jloganolson/logans-first-robot-pcb/red-team-findings/2026-11-10/README.md

# Review material, 10 November 2026

| File | What it is |
|---|---|
| `FINDINGS.md` | The first independent cost and design review that led to v0.10. Partly superseded; see its banner. |
| `evidence/` | Scripts and results behind that review (copper resistance, USB impedance, board occupancy). |
| `argon/` | Two reviews by Google Gemini (Argon), with the prompts used. Reproduced as received; they contain errors. |
| `reviewer-3-feedback.md` | A third AI review that put the order on hold over inductor voltage ratings. |
| `thermal/` | A simple board-heating model and its results. |

How each finding was checked and what was done about it is in
[`docs/HANDOFF_V10_VALUE_ENGINEERED.md`](/docs/HANDOFF_V10_VALUE_ENGINEERED.md).
The prompt files are raw instructions to an AI model and read that way.
