jloganolson/logans-first-robot-pcb/red-team-findings/2026-11-10/reviewer-3-feedback.md

# Third independent review of the Y5 package (10 November 2026)

Pasted by the owner from a separate reviewing agent. Reproduced as received,
with local file links removed. Its datasheet citations were not attached.

> I'd hold payment on Y5. The saved quote is $294.18 before shipping for five
> boards with two assembled. I verified that the board, Gerbers, BOM and
> placement file match the quoted package, including all 304 fitted positions.
> The order files check out.
>
> The reason to hold is six inductors on the battery-fed regulators. Y5 still
> specifies the Sunlord parts at L2-L6 and L7002. Sunlord lists 30 V for both
> exact part numbers. When a regulator starts with its output discharged, the
> voltage across its inductor can approach the full 33.6 V pack voltage during
> a switching pulse. I'd order once Sunlord confirms that waveform is
> acceptable or those six positions use suitably rated parts. The previously
> priced 75 V Vishay option would put Y5 around $307.46 with one additional
> feeder, subject to a fresh quote and footprint check. (Sunlord voltage
> table, p. 21; Vishay ratings.)
>
> The new Thor inductor is an improvement. I independently get about 26.1 A
> peak under overload using the handoff's assumptions. The manufacturer lists
> 29 A as typical at 25 C, at roughly 30% inductance loss. Normal 8 A
> operation has substantially more margin. I'd verify overload behavior with a
> dummy load before connecting Thor. (Cjiang datasheet.)
>
> Before factory release, I'd also ask JLCPCB to confirm the nine large
> electrolytic capacitors stay within Lelon's 250 C case-temperature limit on
> its fixed 255 +/-5 C Economic reflow process. The oven setting alone can't
> establish the capacitor temperature. (Lelon reflow profile; JLCPCB process.)

## Follow-up check

The same Cjiang datasheet (FEXL series, general notes, item 8) states
"absolute maximum voltage: DC 30V". The new Thor inductor L1 therefore has the
same 30 V limit the reviewer raised for the Sunlord parts. See the HOLD section
of `docs/HANDOFF_V10_VALUE_ENGINEERED.md`.
