jloganolson/logans-first-robot-pcb/red-team-findings/2026-11-10/argon/argon-review-of-v11-1c351a03d3f0.md

### Overall Verdict: **DO NOT ORDER (`HOLD` on `Robot_PDB_v11_Gerbers_Y6`)**

While the compact 228 × 155 mm floorplan, the `L1` reversion to the 60 V Coilcraft `XAL1510-103MED`, and the `audit_v11.py` invariant checks outside the servo block are well-conceived, **direct inspection of the v0.11 geometry, layer plots, and JLCPCB placement preview (`outputs/v11-order-preparation/factory-placement-preview-servo-block.png`) reveals multiple critical assembly and layout defects**, plus the unresolved v0.10 component-rating blockers:

1. **BLOCKER (Assembly / CPL Rotations — Visible in `factory-placement-preview-servo-block.png`):**
   - **All `SOT-23` / `SOT-23-5` / `SOT-23-6` parts (`Q7001`, `U7006`, `U7009`, `U1`, `U11`, `U17`, `U9900`, `U9904`) are rotated 90° off their pads** in `CPL_JLCPCB.csv` due to the `(r'^SOT-23', -90)` rule in `export_v11.py`. In `factory-placement-preview-servo-block.png`, the black package bodies and leads of `Q7001` `(110.1, -127.0)`, `U7006` `(151.0, -120.0)`, `U7009` `(153.0, -136.0)`, and `U1` `(23.0, -64.0)` sit vertically (pins North/South) while their copper pads sit horizontally (West/East).
   - **All six `SS1060` buck catch diodes (`D7101` in the servo block, plus `D101, D201, D301, D401, D501` on the main board) are 180° reversed** in `CPL_JLCPCB.csv` (no `^D_SMC` offset in `export_v11.py`). In `factory-placement-preview-servo-block.png`, `D7101` at `(28.5, -135.8)` shows its purple cathode `+` band at the bottom (`y = 139.2`, Pad 2 = `GND`), directly opposite the white silkscreen cathode bar at the top (`y = 132.4`, Pad 1 = `IO_PWM_SW`). `D301` and `D401` show the exact same 180° inversion. Assembling `SS1060` reversed places the Schottky diode forward-biased from `SW` to `GND`, shorting every `TPS54560` high-side FET to ground on the first switching cycle.
2. **BLOCKER (Unresolved from v0.10 Hold):** Six `Sunlord MWSA1004S` buck inductors (`L2–L6, L7002`) remain rated at 30 V DC max against a 33.6 V (8S Li-ion) battery bus, and the nine `10×10 mm` Lelon electrolytic capacitors remain unverified against JLCPCB Economic PCBA’s 255 ± 5 °C peak reflow profile.
3. **HIGH-RISK LAYOUT DEFECTS in the Re-Laid Servo Block (`build_v11.py`):**
   - **Broken high-frequency input capacitor return loop on `U7003` (`C7101–C7103`):** Rotating block `A` placed `C7101–C7103` `GND` pads at `(32.92, 141.8..145.0)` with their 27 `GND` vias at `x = 25.9..31.5`, while `U7003`'s `PWM_VIN` F.Cu zone and vias sit at `x = 34.7..38.7`. **Zero `GND` vias exist in the `U7003` `GND` zone (`x = 24.5..34.1`) closer than 7.5 mm to `U7003` pin 7 (`38.06, 133.1`)**, and the `F.Cu` ground path between `C7101–C7103` `GND` and `U7003` EP (`38.7, 135.8`) is completely severed by `C7104` and the `IO_PWM_SW` pour.
   - **Unnecessary 1,242 mm² overlap between `PWM_VIN` (`B.Cu`, 33.6 V) and `PWM_5V` (`In2.Cu`, 5 V):** `PWM_5V` on `In2.Cu` was drawn from `x = 6.0` to `126.47`, blanketing the entire `PWM_VIN` input section (`x = 35.1..84.6`). Consequently, `F7000` Pad 2 (`PWM_VIN` PTH at `57.25, 125.85`) and all 13 `PWM_VIN` vias punch directly through the `PWM_5V` plane separated by only a `0.30 mm` antipad clearance, and `PWM_VIN` on `B.Cu` capacitively couples across the `0.21 mm` prepreg to `PWM_5V` on `In2.Cu`.
   - **Single 0.30 mm via bottleneck on `C7111` (`100 µF` input bulk capacitor) `GND` and `D7001` (`SMCJ36CA` 5 A TVS) pads:** `C7111` Pad 1 (`PWM_VIN`) has four vias, but `C7111` Pad 2 (`GND`, `66.5, 136.8`) has only **one** `0.30 mm` via (`67.3, 136.8`) and is isolated from the `F.Cu` `GND` pour (`ISLAND_REMOVAL_MODE_ALWAYS` removed the trapped `F.Cu` pour inside `C7111`'s courtyard, visible in `v11-servo-block-F_Cu-and-silk.png`). Worse, `D7001` (`SMCJ36CA` clamping transient surges) connects to `PWM_VIN` (`B.Cu`) and `GND` (`In1.Cu`) through **only a single `0.30 mm` via on each pad** (`76.75, 139.9` and `76.75, 133.1`) at the end of a `0.22 mm` wide `F.Cu` trace!

---

### Detailed Answers to the 9 Review Questions

#### 1. Servo 5 V Buck (`U7003` TPS54560DDAR) and Input Path (`F7000`, `C7111`, `D7001`)
* **Current path from `VIN` (`In2.Cu`) → `F7000` → `PWM_VIN` (`B.Cu`) → `C7111`/`D7001` → `U7003`:**
  * **`VIN` finger on `In2.Cu`:** Runs `x = 93.25..100.25, y = 108.0..128.85` (width `7.0 mm` on 0.5 oz `17.5 µm` copper; cross-section `0.1225 mm²`, `R ≈ 3.1 mΩ` over 20 mm). At 5 A continuous (or ~1.1 A input at 24 V → 5 V / 5 A), a 7 mm wide 0.5 oz finger easily carries the current (< 2 °C rise).
  * **CRITICAL — `D7001` (`SMCJ36CA`) and `C7111` (`100 µF`) via/trace bottlenecks:**
    * In `v11-servo-block-geometry.txt` (lines 67–75, 372–373, 1507–1508, 1703–1704, 1773–1777):
      * `D7001` Pad 1 (`PWM_VIN` at `75.95, 139.9`) is on `F.Cu`, where there is **no `PWM_VIN` zone**. Its entire connection to the `B.Cu` `PWM_VIN` plane is a single **`0.22 mm` wide, `0.8 mm` long `F.Cu` track** (`75.95,139.9 -> 76.75,139.9`) into a **single `0.6/0.3 mm` via** (`76.75, 139.9`)!
      * `D7001` Pad 2 (`GND` at `75.95, 133.1`) is enclosed inside `D7001`'s silkscreen/courtyard box (`v11-servo-block-F_Cu-and-silk.png`), which isolated it from the `F.Cu` `GND` pour; it connects to `GND` solely through a **`0.22 mm` wide `F.Cu` stub** into a **single `0.6/0.3 mm` via** (`76.75, 133.1`)! A `SMCJ36CA` TVS is rated for ~25 A peak pulse current; a `0.22 mm` trace and a single `0.3 mm` via will fuse open during a clamping event.
      * Similarly, `C7111` Pad 2 (`GND` at `66.5, 136.8`) is isolated on `F.Cu` (the `GND` pour inside `C7111`'s outline was removed as an island) and connects to `In1.Cu`/`B.Cu` `GND` via **one `0.22 mm` stub (`66.5,136.8 -> 67.3,136.8`) and one `0.6/0.3 mm` via** (`67.3, 136.8`).
  * **High-frequency input loop (`C7101/C7102/C7103` to `U7003` pin 2 `VIN` and pin 7/EP `GND`):**
    * `U7003` pin 2 (`PWM_VIN`) is at `(38.06, 138.5)` and `C7101–C7103` Pad 1 (`PWM_VIN`) are at `x = 34.87..35.87, y = 139.2..145.0`, joined directly by the `F.Cu` `PWM_VIN` zone (`34.7, 137.7 .. 38.7, 147.8`). That half of the loop is tight.
    * **However, the `GND` return half is wide:** `C7101–C7103` Pad 2 (`GND`) are at `x = 32.92..33.32, y = 139.2..145.0` in the `F.Cu` `GND` zone (`24.5, 137.4 .. 34.1, 147.8`). Between that zone (`x ≤ 34.1`) and `U7003`'s thermal pad (`38.7, 135.8`), `C7104` (`35.1, 136.8`) and the `IO_PWM_SW` pour (`22.1, 122.7 .. 40.05, 136.1`) block any direct `F.Cu` connection. Thus, the high-frequency switching input current (`di/dt`) must go down the `GND` vias at `x = 31.5, y = 141.4..147.0` onto `In1.Cu` and back up `U7003`'s thermal vias at `x = 36.9..40.5, y = 135.2..136.4`—a ~8–10 mm loop on `In1.Cu`. Adding 2–3 `GND` vias at `(33.5, 139.0)` directly beside `C7103` Pad 2 would tighten this loop.
  * **`PWM_VIN` island on `B.Cu` (`x = 35.1..84.6, y = 120.0..148.2`):**
    * **Overlap with `IO_PWM_SW` (`F.Cu`) and `L7002`:** `IO_PWM_SW` on `F.Cu` spans `x = 22.1..40.05, y = 122.7..136.1`, and `L7002` Pad 1 (`IO_PWM_SW`) is at `(37.95, 124.8)` (pad extends to `x = 40.0`). Thus, `PWM_VIN` on `B.Cu` (`x ≥ 35.1, y ≥ 120.0`) overlaps `L7002`'s switch-node pad and the `IO_PWM_SW` zone over `x = 35.1..40.05, y = 122.7..136.1` (~67 mm²). Because solid `In1.Cu` (`GND`) and `In2.Cu` (`PWM_5V`) sit between `F.Cu` and `B.Cu`, direct capacitive coupling from `F.Cu` (`SW`) to `B.Cu` (`PWM_VIN`) is shielded.
    * **Real issue with `PWM_VIN` (`B.Cu`) and `PWM_5V` (`In2.Cu`):** `PWM_VIN` (`B.Cu`, `x = 35.1..84.6, y = 120.0..148.2`) lies directly beneath `PWM_5V` (`In2.Cu`, `x = 6.0..126.47, y = 112.6..154.4`), separated only by the `0.21 mm` `7628` prepreg! There is no reason for `PWM_5V` on `In2.Cu` to extend into `x = 32..60, y = 120..146` where `U7003` (`VIN`/`COMP`/`RT`/`EN`), `C7111`, `D7001`, and `F7000` Pad 2 live. Currently, `U7003`'s `COMP`/`FB`/`RT` ground vias (`45.1, 128.6..141.4`), `U7003`'s 8 `PWM_VIN` vias, `C7111`'s 4 `PWM_VIN` vias, and `F7000` Pad 2 (`PWM_VIN`) all punch through `PWM_5V` (`In2.Cu`) with `0.30 mm` clearance, and `PWM_5V` sits directly under `U7003`'s sensitive analog `FB`/`COMP` network (`x = 39..51, y = 127..133`).
  * **Output path (`L7002` → `C7105–C7108`, `C7112` → `PWM_5V` `In2.Cu` → `J7004–J7006` and `U7007`):**
    * `L7002` Pad 2 (`28.45, 124.8`), `C7105–C7108` Pad 1 (`25.15, 120.6..127.8`), and `C7112` Pad 1 (`13.7, 124.8`) sit in the `F.Cu` `PWM_5V` zone (`13.7, 114.3 .. 31.2, 129.8`, filled `140 mm²`).
    * It drops to `In2.Cu` (`PWM_5V`) through **9 vias of `0.6/0.3 mm`** near `L7002`/`C7105–C7108` (`26.7, 121.8..127.8`, `28.7, 121.8..127.8`, `29.7, 119.8`) plus 1 via at `C7112` (`13.7, 124.0`). At ~0.8–1.0 A per `0.3 mm` via, 9 vias comfortably handle 5 A continuous, and `J7004–J7006` Pin 2 (`PWM_5V`) are PTH pads directly connected (`ZONE_CONNECTION_FULL`) to `In2.Cu` (`PWM_5V`).
    * **Feedback sense (`IO_PWM_FB_TOP` / `R7108` / `R7101`):** `R7101` Pad 1 (`PWM_5V` at `43.92, 130.2`) connects via `(45.1, 130.2)` directly to the `In2.Cu` `PWM_5V` plane (and also has the legacy `0.3 mm` `B.Cu` track to `29.7, 119.8`), so feedback sensing is Kelvin-tapped off the output capacitor region and plane.

#### 2. Eleven Rebuilt Signal Routes and Two Dangling Vias
* **Signal integrity & return paths:**
  * `IO_PWM1_OUT` (`56.08 mm`, 0 vias, `F.Cu`), `IO_PWM2_OUT` (`45.08 mm`, 0 vias, `F.Cu`), and `IO_PWM3_OUT` (`34.08 mm`, 1 via at `123.48, 140.75`, `B.Cu`) are `0.25 mm` wide tracks driven through `100 Ω` series source-termination resistors (`R7054–R7056`) at ~50–500 Hz hobby-servo PWM rates. Over solid `In1.Cu` `GND` (`F.Cu`) and `In2.Cu` `PWM_5V` + `B.Cu` `GND` pour (`B.Cu`), return paths are continuous and well-damped by `R7054–R7056`.
  * **Staircase ("Manhattan/45° sawtooth") routing artifact on `IO_PWM1_OUT`, `IO_PWM2_OUT`, `IO_PWM3_OUT`, `IO_SERVO_ARM`, `IO_V3_PWM`, `IO_PWM_SWCLK`, `IO_PWM_SWDIO`:** Because `Router.path()` in `build_v11.py` searches an 8-connected `0.1 mm` grid without post-smoothing colinear staircases, shallow diagonals are emitted as dozens of `0.1 mm` horizontal + `0.14 mm` diagonal micro-jogs (e.g., lines 479–547 of `v11-servo-block-geometry.txt` have **68 track segments** just to traverse 8 mm from `x = 74.08, y = 147.15` to `66.68, 150.6`). Electrically and for Gerber photoplotting (`0.20–0.25 mm` aperture) this is benign, though unsightly.
  * **Redundant `IO_V3_PWM` `0.20 mm` `F.Cu` track (`45.98 mm`):** `build_v11.py` routed a `0.20 mm` `F.Cu` trace from `TP7002` (`156.0, 150.0`) along the bottom edge (`y = 153.1`) to `J7008` Pin 1 (`112.17, 151.0`). Because `J7008` Pin 1 is only the SWD target-voltage sense (`VREF`, < 1 mA; `hand-fit-and-harness.csv` explicitly warns *"do not inject debugger power"*), a `0.20 mm` trace is electrically adequate, though extending the `In2.Cu` `IO_V3_PWM` zone left from `x = 127.07` to `111.0` would have connected `J7008` Pin 1 directly on the plane without slicing the bottom `F.Cu` ground pour.
  * **`SWD` lines (`IO_PWM_SWDIO` `28.5 mm`, `IO_PWM_SWCLK` `24.82 mm`, `IO_PWM_NRST` `18.34 mm`):** Short (< 30 mm), continuous `GND` reference on `In1.Cu` and `F.Cu`/`B.Cu` pours; completely fine for 4–8 MHz SWD debugging.
  * **Two dangling vias (`IO_PWM2_OUT` at `118.86, 138.0775` and `IO_PWM3_OUT` at `122.81, 138.2275`):** Confirmed harmless `0.25 mm` stub vias next to `R7055`/`R7056` Pad 2 (`119.08, 138.15` and `123.08, 138.15`). Easily pruned in `build_v11.py` by removing stub tracks ending at a via with no second-layer connection.

#### 3. Servo Controller (`U7002` STM32F072CBT6) and USB Tail (`P4_DP`, `P4_DM`, `V5_USB`)
* **`P4_DP` / `P4_DM` length and symmetry:** Shortened from `172.84 / 173.41 mm` in v0.10 to `109.84 / 110.41 mm` in v0.11 (`Δ = 0.57 mm`, well within USB 2.0 Full-Speed 12 Mbps skew budgets of several centimetres).
* **Geometry and reference plane (`v11-servo-block-geometry.txt` lines 1443–1493):**
  * From the hub side (`y = 100..109`), `P4_DP`/`P4_DM` run on `B.Cu` (`0.17 mm` width, `0.46 mm` centre-to-centre pitch → `0.29 mm` gap) over the dedicated `In2.Cu` `GND` shield island (`zone GND In2.Cu prio 100 bbox 168.54,97.83..172.46,110.17`), transition through the pair vias at `(170.15, 109.0)` and `(170.85, 109.0)` flanked by twin ground return vias at `(169.2, 109.0)` and `(171.8, 109.0)`, and then run exclusively on `F.Cu` (`170.27, 110.0` → `163.27, 116.4..133.4` → `U7009` ESD array → `U7002` pins 32/33) over the **unbroken `In1.Cu` `GND` plane**. This is a clean Full-Speed USB layout improvement over v0.10.
* **Decoupling, crystal (`Y7002`), and `U7006` (`3.3 V` LDO):** Rigidly translated by `(+51.0, -12.0) mm`; all local decoupling (`C7021–C7028`), crystal loading (`Y7002`, `C7029`, `C7030`), and `IO_V3_PWM` `In2.Cu` plane connections (`x = 127.07..167.18, y = 112.6..154.4`) are intact.

#### 4. Thermal Impact on `U7003` (Servo 5 V Buck)
* `U7003` (`TPS54560DDAR`) steps ~24–29.6 V down to 5.0 V at up to 5 A peak (typically 0.5–1.5 A average for three `MG90S` micro-servos; even 3× stalled `MG90S` at ~0.75 A each is ~2.25 A).
* At 1.5 A average (`7.5 W` out), `U7003` + `D7101` + `L7002` dissipate ~`1.1 W` total; at 3 A continuous (`15 W` out), ~`2.4 W`.
* `U7003`'s exposed thermal pad (`38.7, 135.8`) has 8× `0.30 mm` thermal vias stitching directly into the full-board `In1.Cu` `GND` plane (`33,765 mm²`) and the new `F.Cu` (`8,284 mm²`) and `B.Cu` (`8,167 mm²`) lower-strip ground pours. Moreover, moving `U7003` into the bottom-left corner keeps it ≥ 50 mm away from the main board's hot spots (`U7` AUX 12 V buck at `151.5, 40.0` and `U2` Thor buck at `60.0, 34.0`). Thermal performance of `U7003` in v0.11 is **better than v0.10** and is not a thermal risk.

#### 5. Mechanical Changes, Edge Clearances, and Silkscreen Collisions
* **Board outline & mounting holes:** Outline is `228.0 × 155.0 mm`. Three M3 NPTH holes moved (`H7002` to `105.17, 151.3`, `H7003` to `3.5, 151.5`, `H7004` to `176.0, 151.5`); `H7001` (`3.0, 116.0`, wall `1.4 mm` to left edge) and the 11 main-board holes are unchanged. **Owner/mechanical CAD sign-off is required** for the 40 mm shorter lower edge, the 3 moved holes, and the new positions of `J7004–J7006`, `J7008`, `J9928`, and `F7000`.
* **Bottom-edge connector & silkscreen clearances (`H = 155.0 mm`):**
  * `J7004–J7006` pads are at `y = 150.6` (`3.55 mm` pad-edge to board edge); `J7008` pads are at `y = 151.0` (`3.15 mm` to board edge).
  * **Silkscreen clipping on `J7008 PWM SWD`:** In `build_v11.py` line 225, `texts['J7008 PWM SWD']` was placed at `y = 151.0 + 3.0 = 154.0 mm` (1.0 mm from the bottom edge). In `v11-servo-block-F_Cu-and-silk.png`, the text `J7008 PWM SWD` sits directly across the bottom silkscreen courtyard line of `J7008` and within ~0.5 mm of the bottom `Edge.Cuts` line.
  * **Silkscreen misplacement on `F7000 PWM 5A`:** `F7000` spans `x = 55.0..99.5, y = 121.6..130.1`, with its two PTH pads at `(57.25, 125.85)` and `(97.25, 125.85)`. Because `build_v11.py` line 226 computed `q = xy(fps['F7000'].GetPosition())` (`97.25, 125.85`) and set the text to `(q[0] - 20.0, q[1] - 5.2) = (77.25, 120.65)`, that works, **Wait:** in `v11-servo-block-F_Cu-and-silk.png`, look at the two mounting holes `H9910` (`58.0, 115.0`) and `H9911` (`86.0, 115.0`) and `F7000`'s pads at `(57.25, 125.85)` and `(97.25, 125.85)`: `F7000` has **no courtyard or body outline on `F.SilkS`**, so only two bare rings appear 40 mm apart with `F7000 PWM 5A` floating between them. Worse, `C7111` (`62.5, 136.8`, `10×10 mm` cap, top edge `y = 131.4`) and `D7001` (`75.95, 136.5`, top edge `y = 131.6`) sit only **1.3–1.5 mm below the 45 mm long body of the Schurter `8020.5075.PT` cartridge fuse (`y = 121.6..130.1`)**—tight for hand soldering a large cartridge fuse next to a `10×10 mm` electrolytic cap.

#### 6. Audit Script (`audit_v11.py`) Blind Spots
`audit_v11.py` accurately verifies that the 291 non-servo footprints, pads, tracks, and zones above `y = 110.5` match v0.10 and that schematic-to-board netlists match. However, it has **five significant blind spots**:
1. **Does not audit `CPL_JLCPCB.csv` rotations against package pin-1 / cathode geometry:** `export_v11.py` only asserts that unmoved parts kept their v0.10 CPL rotation and moved parts changed by `turn`. Because v0.10's CPL rotations were never audited part-by-part, `export_v11.py` faithfully propagated the 90°-rotated `SOT-23`s and 180°-reversed `D_SMC` diodes into v0.11.
2. **Does not check via count or trace width on high-current / surge pads inside the servo block:** It cannot catch that `D7001` (`SMCJ36CA`) and `C7111` (`GND`) are necked down to a single `0.22 mm` trace and a single `0.30 mm` via.
3. **Does not check cross-layer plane overlap hazards:** It does not flag that `PWM_VIN` (33.6 V) on `B.Cu` and `PWM_5V` (5 V) on `In2.Cu` overlap across `1,242 mm²` or that `F7000` Pad 2 (`PWM_VIN`) punches through `PWM_5V` with `0.30 mm` clearance.
4. **Does not check `F.Cu` zone island removal around SMD pads:** It did not catch that `ISLAND_REMOVAL_MODE_ALWAYS` deleted the `F.Cu` `GND` pour around `C7111` Pad 2 and `D7001` Pad 2 because their own silkscreen/courtyard/pad geometries pinched off the `0.25 mm` minimum pour width.
5. **Allows dangling vias/tracks if total DRC warning count ≤ v0.10 (`sum(kinds.values()) <= sum(base.values())`):** Because one `track_dangling` warning disappeared in v0.11 (`10 → 9`), `audit_v11.py` allowed a new `via_dangling` warning (`1 → 2`) to pass silently.

#### 7. Open Items from the v0.10 Hold (`L1`, `L2–L6`/`L7002`, Electrolytic Reflow)
* **`L1` (`Coilcraft XAL1510-103MED`, LCSC `C3911782`, 60 V):** **Resolved.** `BOM_JLCPCB.csv` line 12 specifies `10uH 22A 60V,L1,L_Coilcraft_XAL1510-103,C3911782`, matching the schematic and board.
* **`L2–L6, L7002` (`Sunlord MWSA1004S`, LCSC `C408487` / `C408485`, 30 V rated):** **NOT resolved — still a BLOCKER for 8S (33.6 V max) operation.** During buck high-side FET on-time into a discharged output (startup or output short), the full input voltage (`V_IN - V_OUT`, up to `33.6 V` at startup) appears across the inductor terminals, exceeding the 30 V DC rating of the `MWSA1004S` family (`L2, L3, L4, L5, L6, L7002`). (Note: `L70–L73` are on the 12 V audio speaker outputs and are well within 30 V.)
* **Nine `10×10 mm` Lelon electrolytic capacitors (`C3, C4, C14, C7111` `C249468`; `C20` `C3029711`; `C311, C411, C7112, C88` `C249933`) in Economic reflow:** **NOT resolved.** Standard 10×10 mm SMD aluminum electrolytics are rated for 235–250 °C peak reflow depending on voltage class, whereas JLCPCB Economic PCBA runs a fixed 255 ± 5 °C profile. Either confirm the profile with JLCPCB engineering during manual review, hand-solder the 9 electrolytics, or upgrade to Standard PCBA.

#### 8. BOM, CPL Placement Rotations, and Factory Quote (`Robot_PDB_v11_Gerbers_Y6`, $305.40)
* **Factory quote consistency:** The quote (`53.75` PCB + `251.65` Economic PCBA = **$305.40** for 5 bare / 2 assembled) matches `package-1c351a03d3f0`, `JLC04161H-7628`, 1 oz / 0.5 oz copper, Lead-Free HASL, plugged vias, and 81/81 matched BOM lines.
* **CRITICAL CPL Rotation Defects Found by Cross-Checking `CPL_JLCPCB.csv`, `v11-servo-block-geometry.txt`, and `factory-placement-preview-servo-block.png`:**

| Designators | Footprint / LCSC | Current `CPL_JLCPCB.csv` Rot | Defect Seen in Preview & Pad Coordinates | Required Fix in `export_v11.py` |
|---|---|---|---|---|
| `D101, D201, D501` | `D_SMC` (`SS1060`, `C2922189`) | `180.0°` | Cathode band in JLCPCB preview is on the **right (`+x`, `GND`)**, 180° opposite the silkscreen cathode bar on the **left (`-x`, `SW`)**. | Add `(r'^D_SMC', 180)` to `OFFSETS` (so `180° → 0°`) |
| `D301, D401` | `D_SMC` (`SS1060`, `C2922189`) | `0.0°` | Cathode band in JLCPCB preview is on the **left (`-x`, `GND`)**, 180° opposite the silkscreen cathode bar on the **right (`+x`, `SW`)**. | Add `(r'^D_SMC', 180)` to `OFFSETS` (so `0° → 180°`) |
| `D7101` | `D_SMC` (`SS1060`, `C2922189`) | `270.0°` | Cathode band in JLCPCB preview is at the **bottom (`y=139.2`, `GND`)**, 180° opposite Pad 1 (`y=132.4`, `IO_PWM_SW`) and silkscreen bar. | Add `(r'^D_SMC', 180)` to `OFFSETS` (so `270° → 90°`) |
| `Q7001` | `SOT-23` (`MMBT3904`, `C20526`) | `270.0°` (`0° - 90°`) | Pads 1/2 are on the left (`x=109.14`), Pad 3 on the right (`x=111.02`), but the preview body is rotated **90° off the pads** (leads top/bottom). | Change `^SOT-23` offset (verify `0°` or `180°` in viewer) |
| `U1, U11, U17, U7006, U7009, U9900, U9904` | `SOT-23-5` / `SOT-23-6` | `270.0°` (`0° - 90°`) | Pads 1–3 are on the left, Pads 4–5/6 on the right, but the preview bodies are rotated **90° off their pads** (leads top/bottom). | Fix `^SOT-23` offset in `OFFSETS` (likely `0°` or `180°`) |
| `D2, D3, D60, D102, D202, D302, D402, D502, D7102` | `LED_0603_1608Metric` (`C12624`) | `0° / 90° / 180° / 270°` (0° offset) | In KiCad `LED_0603_1608Metric`, Pad 1 is **Cathode** (`GND`) and Pad 2 is **Anode**. In `factory-placement-preview-servo-block.png`, the purple `+` dot sits on Pad 1 (`GND`). | Verify `C12624` anode/cathode orientation (`180°` offset likely required) |

* **Electrolytic capacitors (`C3, C4, C14, C20, C88, C311, C411, C7111, C7112`):** Verified **CORRECT** in `factory-placement-preview-servo-block.png`—the `(r'^CP_Elec_10x10', 180)` offset places the purple `+` mark on Pad 1 (positive rail) matching the `+` silkscreen mark on all moved (`C7111`, `C7112`) and unmoved electrolytics.
* **`U3–U7, U7003` (`TPS54560DDAR`) and `U7002` (`STM32F072CBT6`) and `U7007` (`SN74AHCT125`):** Verified **CORRECT** in `factory-placement-preview-servo-block.png`—pin 1 dots in the preview match Pad 1 on the copper.

#### 9. Independent Recalculation of Thor 24 V Buck (`U2` LM5146RGYR) Current Limit with `R13 = 220 Ω`
In `LM5146RGYR` (`U2`), low-side $R_{\text{DS(on)}}$ current sensing sets the valley inductor current threshold:
$$I_{\text{valley}} = \frac{I_{\text{RDSON}} \cdot R_{13} + V_{\text{ACL(offset)}}}{R_{\text{DS(on),Q3}}(T_J)}$$
* **Parameters from TI `LM5146` and Infineon `BSC034N06NS` (`Q3`) datasheets:**
  * $R_{13} = 220\ \Omega \pm 1\%$ (`217.8` to `222.2 Ω`).
  * $I_{\text{RDSON}}$ (`LM5146` current source at $25^\circ\text{C}$): `180 µA` min / `200 µA` typ / `220 µA` max (with a positive TC of $\approx +0.3\%/^\circ\text{C}$ designed to track MOSFET $R_{\text{DS(on)}}$ over temperature).
  * Sense comparator offset $V_{\text{ACL(offset)}}$: $\pm 3\text{ mV}$ max.
  * `Q3` (`BSC034N06NS`) $R_{\text{DS(on)}}$ at $V_{\text{GS}} = 7.5\text{ V}$ (`LM5146` $V_{\text{CC}} = 7.5\text{ V}$): Datasheet specifies `3.4 mΩ` max (`2.8 mΩ` typ) at $V_{\text{GS}} = 10\text{ V}$ and `4.5 mΩ` max (`3.6 mΩ` typ) at $V_{\text{GS}} = 6\text{ V}$. Interpolating at $V_{\text{GS}} = 7.5\text{ V}$ gives $R_{\text{DS(on)}}(25^\circ\text{C}) \approx 3.1\text{ m\Omega}$ typ, `2.6 mΩ` min, `3.9 mΩ` max.
* **Inductor ripple current $\Delta I_L$ (`L1 = 10 µH`, $V_{\text{OUT}} = 24\text{ V}$, $f_{\text{SW}} \approx 300\text{ kHz}$ with `R12 = 12 kΩ` or `400 kHz`):**
  * At low battery ($V_{\text{IN}} = 25.5\text{ V}$): $D = 24/25.5 = 0.941$, $\Delta I_L = \frac{(25.5 - 24)\cdot 0.941}{10\text{ \mu H} \cdot f_{\text{SW}}} \approx 0.35\text{–}0.47\text{ A}$.
  * At full 8S battery ($V_{\text{IN}} = 33.6\text{ V}$): $D = 24/33.6 = 0.714$, $\Delta I_L = \frac{(33.6 - 24)\cdot 0.714}{10\text{ \mu H} \cdot f_{\text{SW}}} \approx 1.7\text{–}2.3\text{ A}$.
* **Three Corners:**
  1. **Minimum limit corner (low battery, worst-case negative offset, high $R_{\text{DS(on)}}$):**
     * $V_{\text{sense,min}} = 180\text{ \mu A} \times 217.8\ \Omega - 3\text{ mV} = 39.2\text{ mV} - 3.0\text{ mV} = 36.2\text{ mV}$.
     * With $R_{\text{DS(on),max}} = 3.9\text{ m\Omega}$: $I_{\text{valley,min}} = \frac{36.2\text{ mV}}{3.9\text{ m\Omega}} = 9.28\text{ A}$.
     * Even if `Q3` heats up faster than `U2` ($\Delta T = +25^\circ\text{C}$ uncompensated, $R_{\text{DS(on)}} \approx 4.3\text{ m\Omega}$): $I_{\text{valley,min}} = \frac{36.2\text{ mV}}{4.3\text{ m\Omega}} = 8.42\text{ A}$, giving $I_{\text{DC,min}} = I_{\text{valley,min}} + \frac{\Delta I_L}{2} \approx \mathbf{8.6\text{ A}} > 8.0\text{ A}$. **Passes the 8 A requirement across all corners.**
  2. **Typical corner ($25^\circ\text{C}$, $V_{\text{IN}} = 29.6\text{ V}$):**
     * $V_{\text{sense,typ}} = 200\text{ \mu A} \times 220\ \Omega = 44.0\text{ mV}$; $I_{\text{valley,typ}} = \frac{44.0\text{ mV}}{3.1\text{ m\Omega}} = \mathbf{14.2\text{ A}}$ ($I_{\text{DC,typ}} \approx 15.0\text{ A}$, $I_{\text{peak,typ}} \approx 15.8\text{ A}$).
  3. **Maximum limit / inductor saturation corner (33.6 V battery, positive offset, minimum $R_{\text{DS(on)}} = 2.6\text{ m\Omega}$):**
     * $V_{\text{sense,max}} = 220\text{ \mu A} \times 222.2\ \Omega + 3\text{ mV} = 51.9\text{ mV}$.
     * $I_{\text{valley,max}} = \frac{51.9\text{ mV}}{2.6\text{ m\Omega}} = 19.96\text{ A}$.
     * With $\Delta I_L \approx 2.3\text{ A}$ (plus ~10–15% inductance roll-off near 22 A): $I_{\text{peak,max}} \approx 19.96 + 1.3 = \mathbf{21.3\text{ A}}$ (or up to ~`24 A` during a hard short-circuit before comparator propagation delay).
     * Against the reverted **Coilcraft `XAL1510-103MED`** ($I_{\text{sat}} = 26.3\text{ A}$ for 30% drop at $25^\circ\text{C}$, $I_{\text{rms}} = 22\text{ A}$, 60 V rated), **21.3–24 A peak has a solid margin below saturation**. `R13 = 220 Ω` with `XAL1510-103MED` is well-centered.

---

### Prioritized Action List Before Ordering

1. **[BLOCKER] Fix `CPL_JLCPCB.csv` rotations in `source/fabrication/export_v11.py` and re-verify in JLCPCB preview:**
   * Add `(r'^D_SMC', 180)` to `OFFSETS` so `D101, D201, D301, D401, D501, D7101` (`SS1060`) have their cathode on `SW` and anode on `GND`.
   * Fix the `(r'^SOT-23', -90)` offset in `OFFSETS` so `Q7001`, `U1`, `U11`, `U17`, `U7006`, `U7009`, `U9900`, and `U9904` align with their pads (in `factory-placement-preview-servo-block.png`, all of them are rotated 90° off their pads).
   * Check `LED_0603_1608Metric` (`C12624`, `D2..D7102`) polarity in the JLCPCB viewer and add `(r'^LED_0603', 180)` if the `+` marker is on Pad 1 (`GND`).
2. **[BLOCKER for 8S / 33.6 V] Resolve the 30 V rating on `L2–L6, L7002` (`Sunlord MWSA1004S`) and the 255 °C Economic reflow rating on the 9 electrolytic capacitors.**
3. **[HIGH] Fix the servo block power copper in `source/generator/build_v11.py`:**
   * Add at least 3–4 vias (`0.6/0.3 mm`) on both pads of `D7001` (`SMCJ36CA`) and on `C7111` Pad 2 (`GND`), and widen their `F.Cu` tie tracks from `0.22 mm` to plane polygons or `≥ 1.5 mm` tracks.
   * Add 2–3 `GND` vias at `(33.5, 138.5..140.5)` beside `C7103`/`C7101` Pad 2 to tighten `U7003`'s high-frequency input return loop.
   * Trim `PWM_5V` on `In2.Cu` (`z5` in `build_v11.py` line 330) so it does not blanket the `PWM_VIN` / `F7000` Pad 2 / `U7003` analog area (`x = 34..85, y = 120..146`), eliminating the 1,242 mm² 33.6 V-to-5 V plane overlap and the `0.30 mm` `PWM_5V` antipad around `F7000` Pad 2.
4. **[LOW / CLEANUP]** Prune the two dangling vias (`118.86, 138.08` and `122.81, 138.23`), move the `J7008 PWM SWD` silkscreen label slightly up or left so it does not touch the bottom board edge (`y = 154.0`), and confirm the new mounting hole (`H7002–H7004`) and header (`J7004–J7006`, `J7008`) coordinates against the robot chassis CAD.
