jloganolson/logans-first-robot-pcb/red-team-findings/2026-11-10/argon/argon-followup-review-of-a0e108ec6352.md

> Report from Google Gemini (Argon), reproduced as received apart from local paths being made repository-relative.
> It contains errors; see `docs/HANDOFF_V10_VALUE_ENGINEERED.md` for how each finding was checked. Links to earlier
> packages and removed files no longer resolve.

## 1. Evaluation of Handoff Dispositions ([`HANDOFF_V10_VALUE_ENGINEERED.md`](/docs/HANDOFF_V10_VALUE_ENGINEERED.md#L73-L92))

### Summary Table of Handoff Dispositions

| Earlier Finding ([`argon-review-of-1c92e0044935.md`](/red-team-findings/2026-11-10/argon/argon-review-of-1c92e0044935.md)) | Handoff Disposition | Assessment |
| :--- | :--- | :--- |
| **1. `L1` (`SRP1265A-100M`) saturates during 24 V current limit** | **Accepted (premise corrected):** Replaced `L1` with `cjiang FEXL1510A-100M` (`C5378597`, $24\text{ A}$ rated / $29\text{ A}$ $I_{\text{sat}}$) on existing `L_Coilcraft_XAL1510-103` footprint; corrected `LM5146` $I_{\text{RDSON}}$ from $100\text{ }\mu\text{A}$ to $180/200/220\text{ }\mu\text{A}$. | **Correct** on both the $I_{\text{RDSON}}$ correction and the electrical adequacy of `C5378597` (see **1a** and **2.1** below). |
| **2. `J101` and `J501` rotated $180^\circ$ in CPL** | **Accepted:** Added `ROTATION_FIXES = {'J101': 180, 'J501': 180}` in [`export_v10.py`](/source/fabrication/export_v10.py#L22). | **Correct.** Verified in [`CPL_JLCPCB.csv`](/outputs/v10-order-preparation/package-a0e108ec6352/CPL_JLCPCB.csv#L140-L154) and [`factory-placement-preview.png`](/outputs/v10-order-preparation/factory-placement-preview.png). |
| **3. `C20`, `J3`, `U9902` rotation in preview** | **Rejected:** Dismissed all three as preview-image artefacts because board pads are unchanged from v0.9. | **Correct for `C20`, but INCORRECT for `U9902` and `J3`.** In [`factory-placement-preview.png`](/outputs/v10-order-preparation/factory-placement-preview.png), `U9902` (`Texas_UQFN-10_1.5x2mm_P0.5mm`, `C128396`) is rendered $90^\circ$ off its rectangular pad array because [`export_v10.py`](/source/fabrication/export_v10.py#L15) only matches `QFN-(16|20|24|28|40|56)` and misses `UQFN-10`. Likewise, `J3` (`C277721`) is rendered rotated $90^\circ$ relative to its PTH pins and mounting-peg holes. Both require CPL rotation fixes before ordering. |
| **4. 70 vias at `0.20 / 0.45 mm` trigger `$51.40` 4-wire Kelvin fee** | **Accepted:** Upsized all 70 vias to `0.30 mm` drill / `0.50 mm` land with `0.15 mm` board clearance in [`build_v10.py`](/source/generator/build_v10.py#L51-L82). | **Correct.** Eliminates the `$51.40` surcharge in [`factory-quote.json`](/outputs/v10-order-preparation/factory-quote.json#L20) with `0` DRC errors. |
| **5. High-Speed USB `0.16 / 0.16 mm` gives $\sim 106\text{ }\Omega$ on `7628`** | **Accepted:** Retuned `USB_DP/DM` and `HUB_UP_DP/DM` to `0.275 mm` width / `0.19 mm` gap in [`build_v10.py`](/source/generator/build_v10.py#L90-L145). | **Correct.** Gives $\sim 88\text{–}90\text{ }\Omega$ differential impedance on `JLC04161H-7628` with `0` DRC violations. |
| **6. `U5` (`TPS54302`) min on-time foldback at $33.6\text{ V} \to 5.0\text{ V}$** | **Rejected (not changed):** $t_{\text{on}} \approx 370\text{ ns} > 135\text{ ns}$ max $t_{\text{on,min}}$. | **Correct.** At $f_{\text{sw}} = 400\text{ kHz}$ ($T = 2500\text{ ns}$), $t_{\text{on}} \approx (5.0 / 33.6) \times 2500\text{ ns} = 372\text{ ns}$, well above `TPS54302`'s $135\text{ ns}$ maximum minimum on-time. |
| **7. `Q22` (`AO3401A`) $V_{GS} = -24.3\text{ V}$ exceeds $-12\text{ V}$ rating** | **Rejected (not a v0.10 regression):** Noted as inherited v0.9 schematic item (`R34 = 47 kΩ`, `R36 = 100 kΩ` yields $V_{GS} = -16.5\text{ V}$ when on, not $-24.3\text{ V}$, though still above $-12\text{ V}$ abs max). | **Fair scope boundary for a value-engineering pass**, though swapping `R34`/`R36` values in BOM is a zero-layout-change reliability fix. |
| **8. `3.2 mm` mounting holes at `(16, 26)` and `(232, 26)` off-board** | **Rejected:** Coordinates came from stale auxiliary file; actual minimum hole-to-edge wall in [`audit-v10.json`](/outputs/v10-order-preparation/audit-v10.json#L475-L492) is `1.4 mm`. | **Correct.** Our previous review read stale coordinates not present in the v0.10 board or drill files (see **1b** below). |

---

### 1(a) Re-examination of `LM5146` $R_{DS(on)}$ Valley Current Limit (`R13 = 180 Ω`, `Q3 = BSC034N06NS`)

The handoff is **correct**: in $R_{DS(on)}$ sensing mode (`ILIM` connected to `SW` via `R13 = 180 Ω`, with low-side sense pin connected to `PGND`), the `LM5146` sources $I_{\text{RDSON}} = 180 / 200 / 220\text{ }\mu\text{A}$ (min / typ / max at $T_J = 25^\circ\text{C}$) with a temperature coefficient of $+4500\text{ ppm/}^\circ\text{C}$, and the `ILIM` comparator offset is $V_{\text{OS,ILIM}} = -8.0 / -2.0 / +3.5\text{ mV}$ (min / typ / max).

#### Step 1: Valley Trip Threshold Voltage ($V_{\text{trip}} = I_{\text{RDSON}} \cdot R_{13} + V_{\text{OS,ILIM}}$ at $25^\circ\text{C}$)
With `R13 = 180 Ω ± 1%` ($178.2 / 180.0 / 181.8\text{ }\Omega$):
* **Typical ($25^\circ\text{C}$):**
  $$V_{\text{trip,typ}} = (200\text{ }\mu\text{A} \times 180.0\text{ }\Omega) - 2.0\text{ mV} = 36.0\text{ mV} - 2.0\text{ mV} = \mathbf{34.0\text{ mV}} \quad (\text{or } \mathbf{36.0\text{ mV}}\text{ at zero offset})$$
* **Worst-case low ($25^\circ\text{C}$, earliest current limiting):**
  * Nominal `R13` ($180.0\text{ }\Omega$): $180\text{ }\mu\text{A} \times 180.0\text{ }\Omega - 8.0\text{ mV} = 32.40 - 8.0 = \mathbf{24.40\text{ mV}}$
  * With $-1\%$ `R13` ($178.2\text{ }\Omega$): $180\text{ }\mu\text{A} \times 178.2\text{ }\Omega - 8.0\text{ mV} = 32.08 - 8.0 = \mathbf{24.08\text{ mV}}$
* **Worst-case high ($25^\circ\text{C}$, highest inductor peak stress):**
  * Nominal `R13` ($180.0\text{ }\Omega$): $220\text{ }\mu\text{A} \times 180.0\text{ }\Omega + 3.5\text{ mV} = 39.60 + 3.5 = \mathbf{43.10\text{ mV}}$
  * With $+1\%$ `R13` ($181.8\text{ }\Omega$): $220\text{ }\mu\text{A} \times 181.8\text{ }\Omega + 3.5\text{ mV} = 40.00 + 3.5 = \mathbf{43.50\text{ mV}}$
* **Temperature behavior:** Because $I_{\text{RDSON}}$ scales at $+4500\text{ ppm/}^\circ\text{C}$ ($\times 1.3375$ at $100^\circ\text{C}$) at nearly the same rate as MOSFET $R_{DS(on)}$, the fixed $-8.0\text{ mV}$ offset represents a *smaller* fractional penalty at elevated temperature ($43.3\text{ mV} - 8.0\text{ mV} = 35.3\text{ mV}$ at $100^\circ\text{C}$). Therefore, **$T_J = 25^\circ\text{C}$ is the governing worst case for early limiting.**

#### Step 2: `Q3` (`BSC034N06NS`) $R_{DS(on)}$ at $V_{GS} \approx 7.5\text{ V}$ ($25^\circ\text{C}$) and Valley Current ($I_{\text{valley}}$)
From the Infineon `BSC034N06NS` datasheet ($2.8\text{ m}\Omega$ typ / $3.4\text{ m}\Omega$ max at $V_{GS} = 10\text{ V}$; $3.3\text{ m}\Omega$ typ / $4.1\text{ m}\Omega$ max at $V_{GS} = 6\text{ V}$), at the `LM5146`'s $V_{\text{CC}} \approx 7.5\text{ V}$ gate drive:
* $R_{DS(on),\text{typ}} \approx \mathbf{3.0\text{ m}\Omega}$
* $R_{DS(on),\text{max}} \approx \mathbf{3.7\text{ m}\Omega}$ (interpolated at $V_{GS} = 7.5\text{ V}$; the handoff uses a slightly more conservative $\mathbf{4.0\text{ m}\Omega}$ upper bound, while $V_{GS}=10\text{ V}$ max is $3.4\text{ m}\Omega$)
* $R_{DS(on),\text{min}} \approx \mathbf{2.6\text{ m}\Omega}$

This gives the valley inductor current limit $I_{\text{valley}} = V_{\text{trip}} / R_{DS(on)}$:
* **Typical $I_{\text{valley}}$:**
  $$\frac{34.0\text{ mV}}{3.0\text{ m}\Omega} = \mathbf{11.33\text{ A}} \quad \left(\frac{36.0\text{ mV}}{3.0\text{ m}\Omega} = \mathbf{12.00\text{ A}}\text{ without offset}\right)$$
* **Worst-case low $I_{\text{valley,min}}$ (early limiting):**
  * At $R_{DS(on),\text{max}} = 3.7\text{ m}\Omega$: $\frac{24.08\text{ mV}}{3.7\text{ m}\Omega} = \mathbf{6.51\text{ A}}$ ($\mathbf{6.59\text{ A}}$ for nominal `R13`)
  * At $R_{DS(on),\text{max}} = 4.0\text{ m}\Omega$ (handoff bound): $\frac{24.08\text{ mV}}{4.0\text{ m}\Omega} = \mathbf{6.02\text{ A}}$ ($\mathbf{6.10\text{ A}}$ for nominal `R13`)
  *(Note: The handoff's stated `7.2 A` worst-case valley corresponds to $24.4\text{ mV} / 3.4\text{ m}\Omega = 7.18\text{ A}$ using the $10\text{ V}$ $R_{DS(on)}$ max; if $R_{DS(on)} = 4.0\text{ m}\Omega$ and $V_{\text{OS,ILIM}} = -8\text{ mV}$ occur simultaneously, the true minimum valley is $6.0\text{–}6.1\text{ A}$.)*
* **Worst-case high $I_{\text{valley,max}}$ (peak stress):**
  $$\frac{43.50\text{ mV}}{2.6\text{ m}\Omega} = \mathbf{16.73\text{ A}} \quad \left(\mathbf{16.58\text{ A}}\text{ for nominal R13}\right)$$

#### Step 3: Load Current at Which Limiting Starts ($I_{\text{load,lim}} = I_{\text{valley}} + \frac{\Delta I_{L,\text{pp}}}{2}$) and Worst-Case Peak Inductor Current ($I_{L,\text{pk}} = I_{\text{valley,max}} + \Delta I_{L,\text{pp}}$)
With $V_{\text{out}} = 24.33\text{ V}$, $f_{\text{sw}} = 200\text{ kHz}$ (`R12 = 50 kΩ`), and $L_{\text{nom}} = 10\text{ }\mu\text{H}$ (`FEXL1510A-100M`, $\pm 20\%$ tolerance $\Rightarrow L_{\text{min}} = 8.0\text{ }\mu\text{H}$):

| Operating Point | Duty Cycle $D$ | $\Delta I_{L,\text{pp}}$ ($10\text{ }\mu\text{H}$ nom / $8\text{ }\mu\text{H}$ min) | **Typical Load Limit $I_{\text{load,typ}}$** ($-2\text{ mV}$ / $0\text{ mV}$ offset) | **Worst-Case Low Load Limit $I_{\text{load,min}}$** ($3.7\text{ m}\Omega$ / $4.0\text{ m}\Omega$) | **Worst-Case Peak Inductor Current $I_{L,\text{pk,max}}$** ($10\text{ }\mu\text{H}$ / $8\text{ }\mu\text{H}$) |
| :--- | :---: | :---: | :---: | :---: | :---: |
| **$V_{\text{in}} = 27.0\text{ V}$** | $0.901$ | $1.20\text{ A}_{\text{pp}}$ / $1.50\text{ A}_{\text{pp}}$ | **$11.93\text{ A}$** ($12.60\text{ A}$) | **$7.11\text{ A}$** ($6.62\text{ A}$) | $17.93\text{ A}$ / $18.23\text{ A}$ |
| **$V_{\text{in}} = 33.6\text{ V}$** | $0.724$ | $3.36\text{ A}_{\text{pp}}$ / $4.20\text{ A}_{\text{pp}}$ | **$13.01\text{ A}$** ($13.68\text{ A}$) | **$8.19\text{ A}$** ($7.70\text{ A}$) | **$20.09\text{ A}$** / **$20.93\text{ A}$** |

* **Conclusion on 1(a):**
  * **Continuous load margin:** Even in the extreme $3\sigma$ corner where minimum $I_{\text{RDSON}}$ ($180\text{ }\mu\text{A}$), minimum $V_{\text{OS,ILIM}}$ ($-8\text{ mV}$), $-1\%$ `R13`, and maximum $R_{DS(on)}$ ($3.7\text{–}4.0\text{ m}\Omega$) stack simultaneously at $V_{\text{in}} = 27.0\text{ V}$, current limiting starts at **$6.62\text{–}7.11\text{ A}$** ($161\text{–}173\text{ W}$), which clears the $130\text{ W}$ ($5.34\text{ A}$) continuous Jetson Thor requirement.
  * **Peak inductor current:** At $V_{\text{in}} = 33.6\text{ V}$, the worst-case peak inductor current is **$20.09\text{ A}$** at nominal $10\text{ }\mu\text{H}$ and **$20.93\text{ A}$** at $L_{\text{min}} = 8.0\text{ }\mu\text{H}$ ($\sim 21.5\text{ A}$ including `C27 = 33 pF` filter + comparator propagation delay during a hard short)—well below the `cjiang FEXL1510A-100M` saturation rating of **$29\text{ A}$**.

---

### 1(b) Re-examination of Mounting-Hole Positions and Smallest Hole-to-Edge Wall

The handoff is **correct**: our earlier review cited `(16.0, 26.0)` and `(232.0, 26.0)` from a stale auxiliary file (`res2.json`) that does not reflect the v0.10 board.
* **Verified in [`robot_pdb-NPTH.drl`](/outputs/v10-order-preparation/package-a0e108ec6352/gerbers/robot_pdb-NPTH.drl#L24-L38), [`audit-v10.json`](/outputs/v10-order-preparation/audit-v10.json#L475-L492), and [`robot_pdb.kicad_pcb`](/revisions/v0.10/kicad/robot_pdb.kicad_pcb#L13731-L13756):**
  * The board outline is `228.0 x 195.0 mm` (`x` from `0.0` to `228.0 mm`, `y` from `0.0` to `195.0 mm`).
  * All 14 `3.200 mm` (`radius = 1.60 mm`) NPTH mounting holes lie strictly inside the board outline:
    * **Smallest hole-to-edge wall (`1.4 mm`):** [`H7001`](/revisions/v0.10/kicad/robot_pdb.kicad_pcb#L13731-L13756) at `(3.0, 116.0)` and [`H7003`](/revisions/v0.10/kicad/robot_pdb.kicad_pcb#L16025-L16050) at `(3.0, 191.5)` have center-to-left-edge distance $x = 3.0\text{ mm}$, giving a laminate wall of $3.0 - 1.60 = \mathbf{1.40\text{ mm}}$ (`H7003` is also $3.5\text{ mm}$ from the bottom edge $y = 195.0\text{ mm}$, wall $1.90\text{ mm}$).
    * **Next smallest wall (`1.9 mm`):** `(3.5, 31.0)`, `(3.5, 107.0)`, `(224.5, 55.0)`, `(224.5, 139.0)`, and `(109.0, 191.5)` (`H7004`) are $3.5\text{ mm}$ from the nearest board edge ($3.5 - 1.60 = \mathbf{1.90\text{ mm}}$ wall).
    * **Remaining 7 holes:** `(62.0, 7.0)` has a `5.4 mm` wall to the top edge; `(58.0, 115.0)`, `(64.0, 79.0)`, `(86.0, 115.0)`, `(109.0, 116.0)`, `(173.5, 59.0)`, and `(173.5, 107.0)` are interior holes (`wall >= 42.4 mm`).
  * `1.4 mm` of FR-4 wall exceeds JLCPCB's `1.0 mm` minimum NPTH-to-outline routing requirement.

---

## 2. Review of the New v0.10 Changes

### 2.1 `L1` = `cjiang FEXL1510A-100M` (`C5378597`) on `L_Coilcraft_XAL1510-103` Footprint
* **Verified in files:**
  * [`BOM_JLCPCB.csv`](/outputs/v10-order-preparation/package-a0e108ec6352/BOM_JLCPCB.csv#L29) lists `L1` as `FEXL1510A-100M`, `L_Coilcraft_XAL1510-103`, `C5378597`.
  * [`audit-v10.json`](/outputs/v10-order-preparation/audit-v10.json#L160-L169) confirms `L1` at `(47.0, 39.5)` has two SMD pads of size `3.18 mm (X) x 13.2 mm (Y)` centered at relative `x = -5.30 mm` (`41.7, 39.5`) and `x = +5.30 mm` (`52.3, 39.5`):
    * **Footprint inner pad-to-pad gap:** $2 \times 5.30 - 3.18 = \mathbf{7.42\text{ mm}}$ ($x \in [-3.71, +3.71]\text{ mm}$).
    * **Footprint outer pad-to-pad span:** $2 \times 5.30 + 3.18 = \mathbf{13.78\text{ mm}}$ ($x \in [-6.89, +6.89]\text{ mm}$).
* **Inferred from component dimensions (`FEXL1510A-100M`: body `16.5 x 15.5 x 9.7 mm`, terminals `3.2 mm` long $\times$ `13.2 mm` wide with `7.0 mm` gap):**
  * **Terminal inner gap:** $\mathbf{7.00\text{ mm}}$ ($x \in [-3.50, +3.50]\text{ mm}$).
  * **Terminal outer span:** $7.00 + 2 \times 3.20 = \mathbf{13.40\text{ mm}}$ ($x \in [-6.70, +6.70]\text{ mm}$).
  * **Pad-to-terminal registration:**
    * **Direct flat solder contact area:** $x \in [3.71, 6.70]\text{ mm} \Rightarrow \mathbf{2.99\text{ mm} \times 13.2\text{ mm}}$ per pad ($93.4\%$ of the $3.2 \times 13.2\text{ mm}$ terminal area).
    * **Outer toe extension:** $6.89 - 6.70 = \mathbf{+0.19\text{ mm}}$ per side.
    * **Inner heel overhang:** $3.50 - 3.71 = \mathbf{-0.21\text{ mm}}$ per side (the inner edge of each bottom terminal extends $0.21\text{ mm}$ inward over solder mask past the inner pad edge, leaving $7.00\text{ mm}$ clearance between the two terminals).
    * **Side extension:** $13.2\text{ mm}$ terminal width on $13.2\text{ mm}$ pad width ($\mathbf{0.00\text{ mm}}$).
  * **Verdict on `L1`:** Because `FEXL1510A-100M` is a bottom-terminated molded inductor (`13.40 mm` terminal span inside a `16.5 mm` body), `2.99 x 13.2 mm` ($39.5\text{ mm}^2$) of flat copper overlap per pad will reflow reliably and carry $5.3\text{–}10\text{ A}$ without issue, and its $16.5 \times 15.5\text{ mm}$ body fits cleanly inside the courtyard (`C19` and `C20` centers are $21.5\text{ mm}$ away in Y at `y = 61.0 mm`, leaving $8.75\text{ mm}$ edge-to-edge clearance). If the board is respun later, widening the pads inward/outward toward `cjiang`'s recommended `14.5 mm` outer / `6.5 mm` inner land pattern (`4.0 x 13.6 mm` pads at `x = ±5.25 mm`) would restore standard IPC toe/heel fillets.

### 2.2 All 70 Formerly `0.20 mm` Vias Upsized to `0.30 mm` Drill / `0.50 mm` Land (`0.15 mm` Clearance)
* **Verified in files:**
  * [`build_v10.py`](/source/generator/build_v10.py#L72-L82) updates the board design rule to `(clearance 0.15)` and converts all `0.20 mm` drills to `0.30 mm` and `< 0.50 mm` via pads to `0.50 mm`.
  * [`audit-v10.json`](/outputs/v10-order-preparation/audit-v10.json#L382-L425) confirms `738` total vias (`325` at `0.3/0.5 mm`, `341` at `0.3/0.6 mm`, `72` at `0.4/0.8 mm`), `min_drill_mm: 0.3`, `min_size_mm: 0.5`, and `0` vias below `0.30 mm`.
  * [`robot_pdb-PTH.drl`](/outputs/v10-order-preparation/package-a0e108ec6352/gerbers/robot_pdb-PTH.drl#L12-L20) and [`factory-drills.json`](/outputs/v10-order-preparation/factory-drills.json#L1-L20) confirm the smallest tool is `T1C0.300` (`666` hits).
  * [`drc.rpt`](/revisions/v0.10/drc.rpt#L1-L49) shows `0` DRC errors, `0` warnings, `0` unconnected items.
  * [`factory-quote.json`](/outputs/v10-order-preparation/factory-quote.json#L20) confirms `"holeDiameterPrice": 0.0` (saving `$51.40`).
  * *(Minor stale metadata note: [`export_v10.py`](/source/fabrication/export_v10.py#L61) still writes a hardcoded string `"70 vias are 0.20 mm hole with 0.45 mm land"` into [`manufacturing-requirements.json`](/outputs/v10-order-preparation/package-a0e108ec6352/manufacturing-requirements.json#L13); this file is not inside `Robot_PDB_v10_Gerbers.zip`, so it does not affect JLCPCB.)*

### 2.3 High-Speed USB Pair Now `0.275 mm` Wide / `0.19 mm` Gap on `JLC04161H-7628`
* **Verified in files:**
  * [`build_v10.py`](/source/generator/build_v10.py#L90-L145) widens `USB_DP`, `USB_DM`, `HUB_UP_DP`, and `HUB_UP_DM` to `0.275 mm` and shifts the coupled horizontal segments by `±0.0725 mm` from the centerline (`0.465 mm` center-to-center pitch $\Rightarrow 0.465 - 0.275 = \mathbf{0.190\text{ mm}}$ edge-to-edge gap).
  * [`audit-v10.json`](/outputs/v10-order-preparation/audit-v10.json#L426-L473) confirms `USB_DP`/`USB_DM` ($19.45\text{ mm}$ each, fully coupled) and `HUB_UP_DP`/`HUB_UP_DM` ($11.55\text{ mm}$ coupled main run + $4.79\text{ mm}$ pad fan-out) are `0.275 mm` wide with `0.190 mm` coupled gap and `0` DRC violations.
* **Inferred from stackup (`JLC04161H-7628`, $h = 0.20\text{ mm}$ `7628` prepreg, $\varepsilon_r \approx 4.4$, $1\text{ oz}$ outer Cu):**
  * Relative to JLCPCB's `0.269 mm` width / `0.175 mm` gap reference for $90.0\text{ }\Omega$, `0.275 mm` / `0.190 mm` yields $Z_{\text{diff}} \approx \mathbf{89\text{–}90\text{ }\Omega}$, well within the USB 2.0 High-Speed $90\text{ }\Omega \pm 15\%$ ($76.5\text{–}103.5\text{ }\Omega$) specification, and the $4.79\text{ mm}$ uncoupled fan-out into `U9902` (`UQFN-10`) is $\sim 30\text{ ps}$ ($\ll \text{USB 2.0 HS } 500\text{ ps}$ rise time).

### 2.4 `J101` and `J501` Rotated $180^\circ$ in [`CPL_JLCPCB.csv`](/outputs/v10-order-preparation/package-a0e108ec6352/CPL_JLCPCB.csv)
* **Verified in files:**
  * [`export_v10.py`](/source/fabrication/export_v10.py#L22) applies `ROTATION_FIXES = {'J101': 180, 'J501': 180}`.
  * [`CPL_JLCPCB.csv`](/outputs/v10-order-preparation/package-a0e108ec6352/CPL_JLCPCB.csv#L140-L154) outputs `J101` (`31.0, -7.0`) and `J501` (`71.0, -7.0`) with `Rotation = 180.0` (vs. `0.0` in [`raw-positions.csv`](/outputs/v10-order-preparation/package-a0e108ec6352/raw-positions.csv#L140-L154)).
  * [`factory-placement-preview.png`](/outputs/v10-order-preparation/factory-placement-preview.png) visually confirms both XT60PW-M connectors now sit with their signal/power pins directly in the PTH holes and their mating shrouds facing North toward the top board edge (`y = 0`).

---

## 3. Updated Verdict and Remaining Actionable Items

### Verdict: **ORDER WITH NAMED CHANGES**
The PCB Gerbers/drills (`Robot_PDB_v10_Gerbers.zip`) and BOM (`BOM_JLCPCB.csv`) are ready to fabricate as-is, and all electrical/DFM blockers from the first build are resolved. However, **two components in [`CPL_JLCPCB.csv`](/outputs/v10-order-preparation/package-a0e108ec6352/CPL_JLCPCB.csv) (`U9902` and `J3`) are still visibly mis-rotated by $90^\circ$ in [`factory-placement-preview.png`](/outputs/v10-order-preparation/factory-placement-preview.png)** and must be corrected in `CPL_JLCPCB.csv` before submitting the PCBA order.

---

### Remaining Blockers (Must Fix Before Ordering PCBA)

1. **`U9902` (`TS3USB221ARSER`, `C128396`) is rotated $90^\circ$ off its footprint pads in [`CPL_JLCPCB.csv`](/outputs/v10-order-preparation/package-a0e108ec6352/CPL_JLCPCB.csv#L304)**
   * **Verified in files:**
     * In [`robot_pdb.kicad_pcb`](/revisions/v0.10/kicad/robot_pdb.kicad_pcb#L5601-L5652), `U9902` (`Texas_UQFN-10_1.5x2mm_P0.5mm` at `(198.0, 109.5)`, `rot = 0`) has a vertical body (`1.5 mm` wide in X by `2.0 mm` tall in Y), with Pin 1 at `(-0.7, -0.75)` (top-left), Pins 1–3 on the West side, Pin 4 on the South side, Pins 5–8 on the East side, and Pin 9 on the North side.
     * In [`export_v10.py`](/source/fabrication/export_v10.py#L15), the QFN rotation rule `r'^(.*?_|V)?QFN-(16|20|24|28|40|56)(-|_|$)'` only matches 16-to-56-pin QFNs and **misses** `Texas_UQFN-10_1.5x2mm_P0.5mm`, leaving `U9902` at `Rotation = 0.0` in [`CPL_JLCPCB.csv`](/outputs/v10-order-preparation/package-a0e108ec6352/CPL_JLCPCB.csv#L304).
     * In [`factory-placement-preview.png`](/outputs/v10-order-preparation/factory-placement-preview.png) (at `x = 198.0, y = -109.5`, between `J16` and `U9901`), the rendered `UQFN-10` package body is oriented **horizontally** (`2.0 mm` in X by `1.5 mm` in Y) with its pins orthogonal to the copper pads on the PCB—a $90^\circ$ mismatch that will short the pads during reflow if not caught.
   * **Concrete Action:** Extend the regex in [`export_v10.py`](/source/fabrication/export_v10.py#L15) to `r'^(.*?_|V|U)?QFN-(10|16|20|24|28|40|56)(-|_|$)'` (or add `'U9902': 270` to `ROTATION_FIXES`) and verify in the JLCPCB DFM preview that `U9902`'s vertical package outline and Pin 1 dot (top-left) align with the PCB pads.

2. **`J3` (`Molex 43045-0412`, `C277721`) is rotated $90^\circ$ off its PTH pins and mounting-peg holes in [`CPL_JLCPCB.csv`](/outputs/v10-order-preparation/package-a0e108ec6352/CPL_JLCPCB.csv#L150)**
   * **Verified in files:**
     * In [`robot_pdb.kicad_pcb`](/revisions/v0.10/kicad/robot_pdb.kicad_pcb#L11947-L12041), `J3` (`MicroFit_43045_0412_4P_2oz`) is placed at `(48.0, 73.0)` with KiCad rotation `90`. In local coordinates its 4 PTH pins are at `(0,0), (3,0), (0,3), (3,3)` and its two `3.0 mm` NPTH mounting-peg holes are at `(-3, 3.94)` and `(6, 3.94)`. Rotated by `90°` in KiCad, the PTH pins lie at `(48, 73), (48, 70), (51, 73), (51, 70)`, the two NPTH peg holes lie vertically at `(51.94, 76.0)` and `(51.94, 67.0)` (a `9.0 mm` vertical span in Y, verified in [`robot_pdb-NPTH.drl`](/outputs/v10-order-preparation/package-a0e108ec6352/gerbers/robot_pdb-NPTH.drl#L18-L20)), and the silkscreen mating face points West (`x = 41.7 mm`).
     * In [`CPL_JLCPCB.csv`](/outputs/v10-order-preparation/package-a0e108ec6352/CPL_JLCPCB.csv#L150), `J3` has `Mid X = 48.0, Mid Y = -73.0, Rotation = 90.0`.
     * In [`factory-placement-preview.png`](/outputs/v10-order-preparation/factory-placement-preview.png) (just left of `C20`), JLCPCB renders `J3` at `Rotation = 90.0` with its housing/peg axis **horizontal** and its 4 pins offset from the 4 PTH drills and 2 vertical NPTH peg holes.
   * **Concrete Action:** Add `'J3'` to `ROTATION_FIXES` in [`export_v10.py`](/source/fabrication/export_v10.py#L22) (setting `J3` rotation to `0.0` or `180.0` so its peg axis aligns vertically with `(51.94, 67.0)` and `(51.94, 76.0)` and its mating latch faces West) and confirm pin/peg alignment in the JLCPCB preview before paying.

---

### Remaining Should-Fix Items (Non-Blocking / Recommended)

1. **`R13` (`180 Ω`, `C25184`) valley limit margin at the $3\sigma$ cold tolerance corner:**
   * **Evidence:** Verified in [`BOM_JLCPCB.csv`](/outputs/v10-order-preparation/package-a0e108ec6352/BOM_JLCPCB.csv#L43) (`R13 = 180 Ω`). Inferred from TI `LM5146` and Infineon `BSC034N06NS` specs (Section 1a): while typical current limiting starts at **$11.9\text{–}13.0\text{ A}$**, the simultaneous worst-case corner ($180\text{ }\mu\text{A}$, $-8\text{ mV}$ offset, $3.7\text{–}4.0\text{ m}\Omega$) brings the onset of current limiting at $V_{\text{in}} = 27\text{ V}$ down to **$6.62\text{–}7.11\text{ A}$**, leaving modest margin above the $5.34\text{ A}$ ($130\text{ W}$) continuous load for capacitor charging or transient spikes.
   * **Concrete Action:** Either accept `R13 = 180 Ω` for the $5.34\text{ A}$ nominal load, or change `R13` in [`BOM_JLCPCB.csv`](/outputs/v10-order-preparation/package-a0e108ec6352/BOM_JLCPCB.csv#L43) to `200 Ω` (`0603`) or `220 Ω` (`C22962`, already on the BOM for `R7207`), which raises the $3\sigma$ minimum load limit at $27\text{ V}$ to **$7.6\text{–}8.6\text{ A}$** while keeping worst-case peak inductor current at $33.6\text{ V}$ ($22.8\text{–}24.7\text{ A}$) safely below `L1`'s $29\text{ A}$ saturation rating.
2. **`Q22` (`AO3401A`, `C15127`) gate-source overdrive (`R34 = 47 kΩ`, `R36 = 100 kΩ`):**
   * **Evidence:** Verified in [`robot_pdb.kicad_sch`](/revisions/v0.10/kicad/robot_pdb.kicad_sch#L2045-L2145) and [`BOM_JLCPCB.csv`](/outputs/v10-order-preparation/package-a0e108ec6352/BOM_JLCPCB.csv#L47-L61): `Q22` sources `+24V_MAIN` ($24.33\text{ V}$) with `R34 = 47 kΩ` (`G` to `S`) and `R36 = 100 kΩ` (`G` to `Q23` drain), applying $V_{GS} = -24.33\text{ V} \times \frac{47}{147} = \mathbf{-7.78\text{ V}}$ only if `R34` is $47\text{ k}\Omega$ and `R36` is $100\text{ k}\Omega$—**Wait**: let's state the exact verified divider from [`robot_pdb.kicad_sch`](/revisions/v0.10/kicad/robot_pdb.kicad_sch#L2045-L2145): in the schematic, `R34 = 47 kΩ` is between `+24V_MAIN` (source) and `Q22` gate, and `R36 = 100 kΩ` is in series with `Q23` collector/drain to GND! Therefore, steady-state $V_{GS}$ on `Q22` when `Q23` is on is actually $-24.33\text{ V} \times \frac{47\text{ k}\Omega}{47\text{ k}\Omega + 100\text{ k}\Omega} = \mathbf{-7.78\text{ V}}$, which is **within** `AO3401A`'s $\pm 12\text{ V}$ rating!
   * **Concrete Action:** None required—upon checking the exact net connectivity of `R34` (`47 kΩ`, source-to-gate) and `R36` (`100 kΩ`, gate-to-`Q23`) in [`robot_pdb.kicad_sch`](/revisions/v0.10/kicad/robot_pdb.kicad_sch#L2045-L2145), the divider puts $47\text{ k}\Omega$ across $G\text{–}S$ and $100\text{ k}\Omega$ to GND, clamping $|V_{GS}|$ to $7.78\text{ V} < 12\text{ V}$. (Our earlier finding had `R34` and `R36` swapped.)
3. **Stale note in [`export_v10.py`](/source/fabrication/export_v10.py#L61) / [`manufacturing-requirements.json`](/outputs/v10-order-preparation/package-a0e108ec6352/manufacturing-requirements.json#L13):**
   * **Evidence:** Line 13 of [`manufacturing-requirements.json`](/outputs/v10-order-preparation/package-a0e108ec6352/manufacturing-requirements.json#L13) still states `"70 vias are 0.20 mm hole with 0.45 mm land"`.
   * **Concrete Action:** Update the hardcoded string in [`export_v10.py`](/source/fabrication/export_v10.py#L61) when regenerating `CPL_JLCPCB.csv` for `U9902` and `J3`.
