jloganolson/logans-first-robot-pcb/docs/v11-assets/board-labels.png

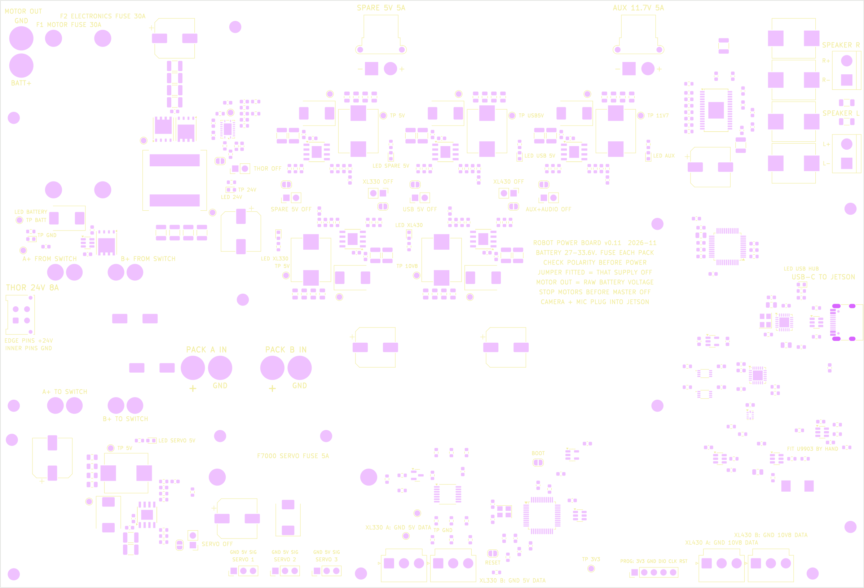
docs/v11-assets/board-labels.png
