jloganolson/logans-first-robot-pcb/docs/v11-assets/factory-quote.png

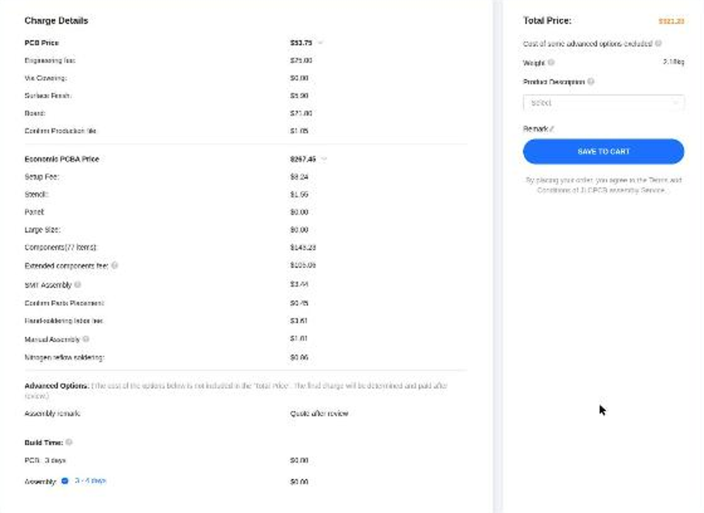
docs/v11-assets/factory-quote.png
