jloganolson/logans-first-robot-pcb/docs/v11-assets/thermal-map.png

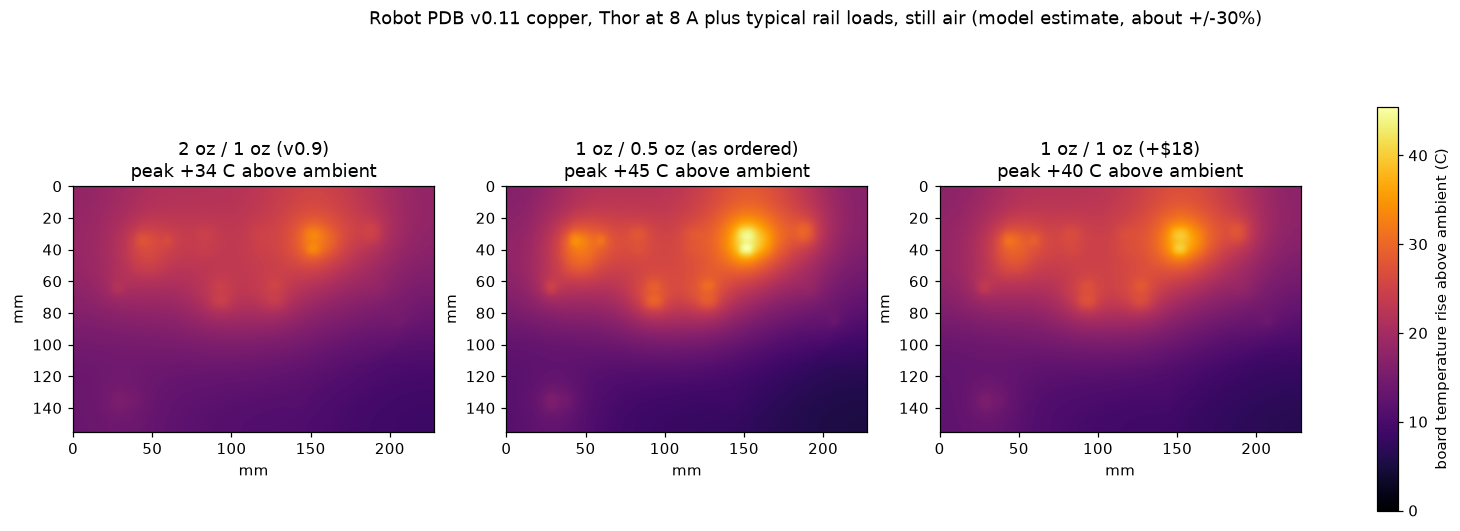
docs/v11-assets/thermal-map.png
