jloganolson/logans-first-robot-pcb/red-team-findings/2026-11-10/thermal/thermal-map.png

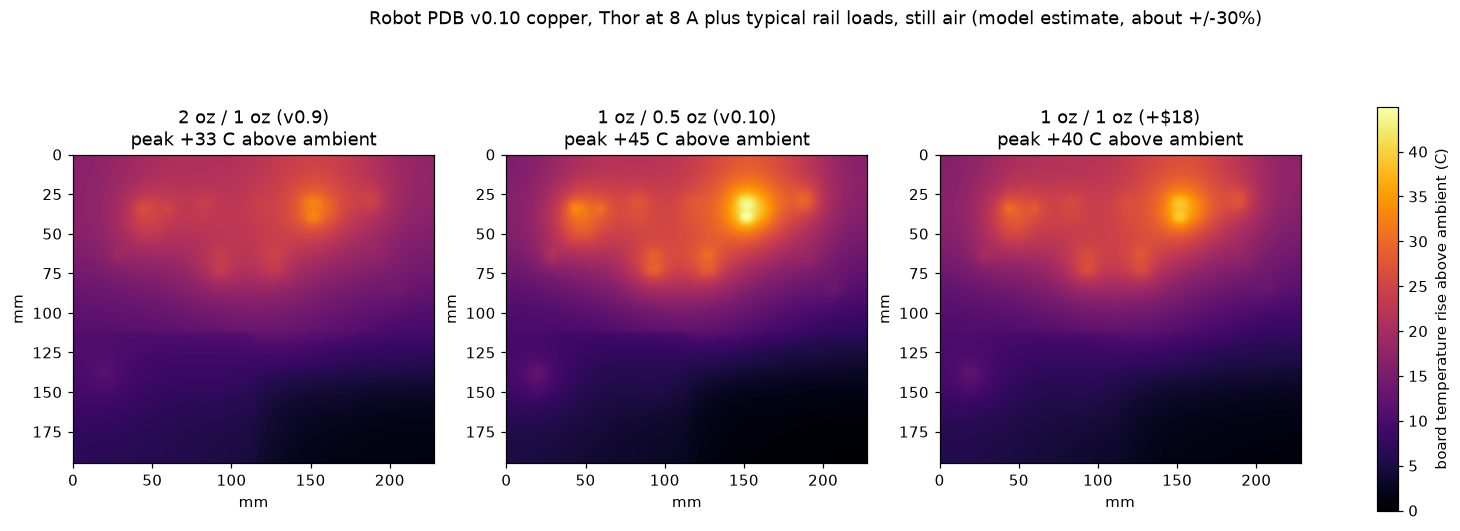
red-team-findings/2026-11-10/thermal/thermal-map.png
