jloganolson/logans-first-robot-pcb/renders/bottom-copper.png

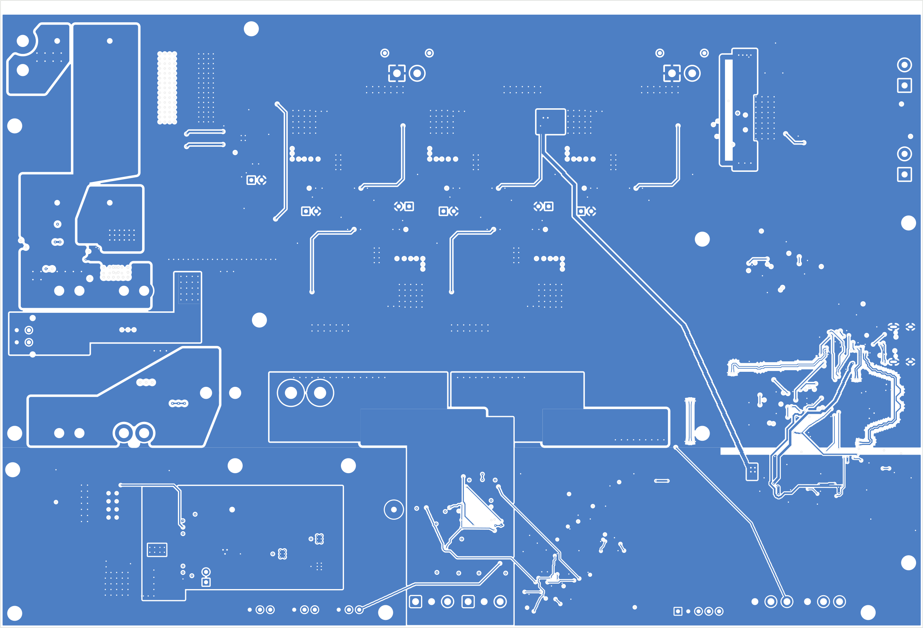
renders/bottom-copper.png
