jloganolson/logans-first-robot-pcb/renders/inner1-ground.png

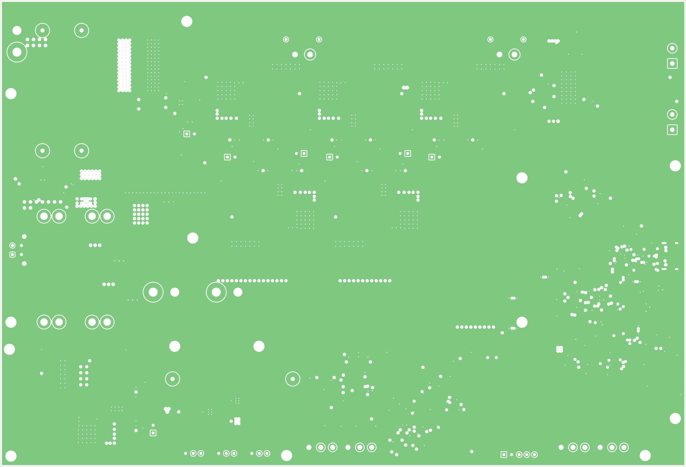
renders/inner1-ground.png
