jloganolson/logans-first-robot-pcb/renders/inner2-power.png

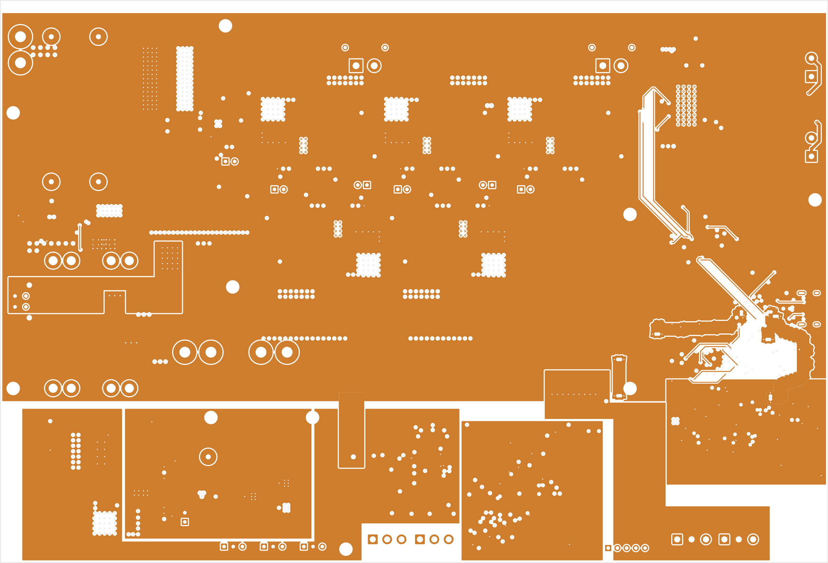
renders/inner2-power.png
