jloganolson/logans-first-robot-pcb/outputs/v11-order-preparation/package-494e931955b1/BOM_JLCPCB.csv

Comment | Designator | Footprint | LCSC Part #
10 | R7021 | R_0603_1608Metric | C22859
100 | R7054,R7055,R7056 | R_0603_1608Metric | C22775
100k | R7048,R7049,R7057,R7058,R7059,R71,R72,R9900,R9904,R9910 | R_0603_1608Metric | C25803
100nF 100V | C1,C103,C15,C203,C303,C403,C5,C503,C7103 | C_0603_1608Metric | C15725
100nF 50V | C104,C2,C204,C22,C304,C404,C504,C61,C64,C67,C7023,C7024,C7025,C7026,C7028,C7043,C71,C7104,C72,C86,C87,C95,C96,C98,C99,C9900,C9905,C9906,C9908 | C_0603_1608Metric | C14663
100uF 63V | C14,C3,C4,C7111 | CP_Elec_10x10 | C249468
10k | R407,R507,R62,R70,R7022,R7023,R7047,R7051,R7052,R7053,R76,R77,R9903 | R_0603_1608Metric | C25804
10uF 25V | C60,C63,C70,C9901 | C_0805_2012Metric | C15850
10uF 50V | C16,C17,C18,C19,C84,C85 | C_1210_3225Metric | C138687
10uH | L70,L71,L72,L73 | L_Sunlord_MWSA1004S | C408487
10uH 75V | L5,L6 | L_Sunlord_MWSA1004S | C845065
10uH 22A 60V | L1 | L_Coilcraft_XAL1510-103 | C3911782
120R 2A | FB1 | L_0603_1608Metric | C14709
12MHz | Y1 | Crystal_SMD_3225-4Pin_3.2x2.5mm | C9002
12V AUX (amp is on board) (XT30 female) | J501 | AMASS_XT30PW_F_2oz | C2913282
12k | R105,R106,R12,R205,R206,R305,R306,R405,R505,R7105,R7106 | R_0603_1608Metric | C22790
150k | R14 | R_0603_1608Metric | C22807
150uF 10V POSCAP | C9902 | Panasonic_POSCAP_D3L | C347559
220 | R13 | R_0603_1608Metric | C22962
18pF 50V | C7029,C7030 | C_0603_1608Metric | C1647
1k | R17,R63 | R_0603_1608Metric | C21190
1nF 50V | C9909 | C_0603_1608Metric | C1588
1uF 25V | C62,C65,C66,C7021,C7027,C78,C79,C80,C81,C82,C83,C97,C9907 | C_0603_1608Metric | C15849
2.2k | R107,R207,R307,R502,R7046,R7107 | R_0603_1608Metric | C4190
2.2nF | C24,C26 | C_0603_1608Metric | C1604
2.2uF 100V | C10,C101,C102,C11,C12,C13,C201,C202,C301,C302,C401,C402,C501,C502,C7101,C7102 | C_1210_3225Metric | C55151
2.4k | R402 | R_0603_1608Metric | C22940
20k | R406,R506,R9908 | R_0603_1608Metric | C4184
220k | R103,R104,R11,R203,R204,R303,R304,R403,R404,R503,R504,R7103,R7104,R9909 | R_0603_1608Metric | C22961
220nF 25V | C89,C90,C91,C92 | C_0603_1608Metric | C21120
220uF 35V | C20 | CP_Elec_10x10 | C3029711
22k | R1,R19 | R_0603_1608Metric | C31850
22uF 25V | C105,C106,C107,C108,C205,C206,C207,C208,C305,C306,C307,C308,C405,C406,C407,C408,C505,C506,C507,C508,C7105,C7106,C7107,C7108 | C_0805_2012Metric | C45783
300 | R7108 | R_0603_1608Metric | C23025
30k | R401,R501,R9901 | R_0603_1608Metric | C22984
33pF 50V | C27 | C_0603_1608Metric | C1663
39k | R101,R201,R301,R7101 | R_0603_1608Metric | C23153
4.7k | R74,R75 | R_0603_1608Metric | C23162
4.7nF | C109,C209,C309,C409,C509,C7109 | C_0603_1608Metric | C53987
4.7uF 16V | C21,C7022,C73,C74,C75,C76,C77 | C_0603_1608Metric | C19666
470uF 25V | C311,C411,C7112,C88 | CP_Elec_10x10 | C249933
47nF | C23 | C_0603_1608Metric | C1622
47pF | C110,C210,C25,C310,C410,C510,C7110 | C_0603_1608Metric | C1671
49.9 | R9906,R9907 | R_0603_1608Metric | C23185
49.9k | R10,R16 | R_0603_1608Metric | C23184
5.1k | R15,R60,R61 | R_0603_1608Metric | C23186
5.6k | R73 | R_0603_1608Metric | C23189
6.8uH 75V | L2,L3,L4,L7002 | L_Sunlord_MWSA1004S | C845080
600R | FB2 | L_0603_1608Metric | C1002
680nF 50V | C93,C94 | C_1206_3216Metric | C1881
7.5k | R102,R202,R302,R7102,R9902 | R_0603_1608Metric | C23234
8MHz CL12pF | Y7002 | Crystal_SMD_3225-4Pin_3.2x2.5mm | C2682775
AP2112K-3.3TRG1 | U17,U7006 | SOT-23-5 | C51118
BSC034N06NS | Q2,Q3 | TDSON-8-1 | C534325
BSC040N10NS5 | Q1 | TDSON-8-1 | C534334
CH334F | U10 | QFN-24-1EP_4x4mm_P0.5mm_EP2.6x2.6mm | C5187527
CH342F | U14 | QFN-24-1EP_4x4mm_P0.5mm_EP2.6x2.6mm | C2841530
CM108B | U12 | LQFP-48_7x7mm_P0.5mm | C371347
Green | D102,D2,D202,D3,D302,D402,D502,D60,D7102 | LED_0603_1608Metric | C12624
LM5146RGYR | U2 | Texas_RGY_R-PVQFN-N20_EP2.05x3.05mm | C3188679
LM74700QDBVRQ1 | U1 | SOT-23-6 | C2941042
MMBT3904 | Q7001 | SOT-23 | C20526
RASPBERRY PI 5V (XT30 female) | J101 | AMASS_XT30PW_F_2oz | C2913282
SMCJ36CA | D1,D7001 | D_SMC | C151283
SN74AHCT125QPWRQ1 | U7007 | TSSOP-14_4.4x5mm_P0.65mm | C507215
SN74LVC2G241DCUR | U15,U16 | VSSOP-8_2.3x2mm_P0.5mm | C10430
SPEAKER L (screw terminal) | J13 | TerminalBlock_bornier-2_P5.08mm | C474881
SPEAKER R (screw terminal) | J14 | TerminalBlock_bornier-2_P5.08mm | C474881
SS1060 | D101,D201,D301,D401,D501,D7101 | D_SMC | C2922189
STM32F072CBT6 | U7002 | LQFP-48_7x7mm_P0.5mm | C81720
THOR 24V MICRO-FIT | J3 | MicroFit_43045_0412_4P_2oz | C277721
TPA3118D2DAPR | U13 | HTSSOP-32-1EP_6.1x11mm_P0.65mm_EP5.2x11mm_Mask4.11x4.36mm_ThermalVias | C46497
TPS2552DBVR | U9900 | SOT-23-6 | C46506
TPS2553DBVR | U9904 | SOT-23-6 | C55266
TPS54560DDAR | U3,U4,U5,U6,U7,U7003 | TI_SO-PowerPAD-8_ThermalVias | C31966
TS3USB221ARSER | U9902 | Texas_UQFN-10_1.5x2mm_P0.5mm | C128396
USB-C to Jetson | J10 | USB_C_HRO_31M12_2oz | C165948
USBLC6-2SC6 | U11,U7009 | SOT-23-6 | C7519
XL330 5V CHAIN A | J301 | JST_VH_B3P-VH_1x03_P3.96mm_Vertical | C160316
XL330 5V CHAIN B | J302 | JST_VH_B3P-VH_1x03_P3.96mm_Vertical | C160316
XL430 10.8V CHAIN | J401 | JST_VH_B3P-VH_1x03_P3.96mm_Vertical | C160316
XL430 10.8V CHAIN B | J402 | JST_VH_B3P-VH_1x03_P3.96mm_Vertical | C160316
