jloganolson/logans-first-robot-pcb/outputs/v11-order-preparation/package-494e931955b1/hand-fit-and-harness.csv

Reference | Requirement | Description | Manufacturer part | Supplier part | Notes | Observed unit price | Currency | Source
F1 | MANUAL ITEM; review stated requirement | MOTOR 30A 500VDC | Littelfuse 0505030.MXEP 30A 500VDC 20kA interrupt, axial lead | C187656 | hand-solder after SMT; verify pulse/fault/thermal coordination
F2 | MANUAL ITEM; review stated requirement | ELECTRONICS 30A 500VDC | Littelfuse 0505030.MXEP 30A 500VDC 20kA interrupt, axial lead | C187656 | hand-solder after SMT; verify pulse/fault/thermal coordination
F7000 | MANUAL ITEM; review stated requirement | 5A63VDC20kA | SCHURTER8020.5075.PT |  | mandatory hand-fit; verify overload coordination
H1 | MANUAL ITEM; review stated requirement | M3
H2 | MANUAL ITEM; review stated requirement | M3
H3 | MANUAL ITEM; review stated requirement | M3
H4 | MANUAL ITEM; review stated requirement | M3
H5 | MANUAL ITEM; review stated requirement | M3
H6 | MANUAL ITEM; review stated requirement | M3
H7 | MANUAL ITEM; review stated requirement | M3
H7001 | MANUAL ITEM; review stated requirement | M3 NPTH | M3 NPTH
H7002 | MANUAL ITEM; review stated requirement | M3 NPTH | M3 NPTH
H7003 | MANUAL ITEM; review stated requirement | M3 NPTH | M3 NPTH
H7004 | MANUAL ITEM; review stated requirement | M3 NPTH | M3 NPTH
H9910 | MANUAL ITEM; review stated requirement | M3 NYLON SUPPORT | M3 nylon/insulating standoff |  | harness strain relief
H9911 | MANUAL ITEM; review stated requirement | M3 NYLON SUPPORT | M3 nylon/insulating standoff |  | harness strain relief
H9912 | MANUAL ITEM; review stated requirement | M3 NYLON SUPPORT | M3 nylon/insulating standoff |  | harness strain relief
J1 | MANUAL ITEM; review stated requirement | PACK A (XT60 male) | Hand-soldered 12AWG power pigtail; external XT60 mating end; strain relief required |  | hand-wire after SMT
J2 | MANUAL ITEM; review stated requirement | FUSED BATTERY MOTOR PASSTHROUGH | Hand-soldered 12AWG power pigtail; external XT60 mating end; strain relief required |  | hand-wire after SMT
J4 | MANUAL ITEM; review stated requirement | PACK B (XT60 male) | Hand-soldered 12AWG power pigtail; external XT60 mating end; strain relief required |  | hand-wire after SMT
J5 | MANUAL ITEM; review stated requirement | EXTERNAL DPST POWER WIRES | Four hand-soldered 12AWG wires to external mechanical DPST, no fitted PCB switch |  | wire interface; strain relief required
J7004 | MANUAL ITEM; review stated requirement | MG90S1:GND/+5V/PWM | hand-fit three-pin servo header; center pin+5V |  | verify actual cable polarity before plugging in
J7005 | MANUAL ITEM; review stated requirement | MG90S2:GND/+5V/PWM | hand-fit three-pin servo header; center pin+5V |  | verify actual cable polarity before plugging in
J7006 | MANUAL ITEM; review stated requirement | MG90S3:GND/+5V/PWM | hand-fit three-pin servo header; center pin+5V |  | verify actual cable polarity before plugging in
J7008 | MANUAL ITEM; review stated requirement | PWM SWD:VREF/GND/DIO/CLK/RESET | hand-fit SWD service header; pin1 is target-reference sense |  | do not inject debugger power
J9921 | OPTIONAL / OMIT BY DEFAULT | THOR OFF SHUNT | Optional hand-fit 2.54mm two-pin header and removable shunt |  | short=OFF; open=normal UVLO; no external voltage; optional service control, not protection
J9922 | OPTIONAL / OMIT BY DEFAULT | PI OFF SHUNT | Optional hand-fit 2.54mm two-pin header and removable shunt |  | short=OFF; open=normal UVLO; no external voltage; optional service control, not protection
J9923 | OPTIONAL / OMIT BY DEFAULT | USB CONTROL OFF SHUNT | Optional hand-fit 2.54mm two-pin header and removable shunt |  | short=OFF; open=normal UVLO; no external voltage; optional service control, not protection
J9924 | OPTIONAL / OMIT BY DEFAULT | XL330 OFF SHUNT | Optional hand-fit 2.54mm two-pin header and removable shunt |  | short=OFF; open=normal UVLO; no external voltage; optional service control, not protection
J9925 | OPTIONAL / OMIT BY DEFAULT | XL430 OFF SHUNT | Optional hand-fit 2.54mm two-pin header and removable shunt |  | short=OFF; open=normal UVLO; no external voltage; optional service control, not protection
J9926 | OPTIONAL / OMIT BY DEFAULT | AUDIO AUX OFF SHUNT | Optional hand-fit 2.54mm two-pin header and removable shunt |  | short=OFF; open=normal UVLO; no external voltage; optional service control, not protection
J9928 | OPTIONAL / OMIT BY DEFAULT | MG90S OFF SHUNT | Optional hand-fit 2.54mm two-pin header and removable shunt |  | short=OFF; open=normal UVLO; no external voltage; optional service control, not protection
JP1 | MANUAL ITEM; review stated requirement | 24V OFF | solder jumper (open, bridge with solder)
JP101 | MANUAL ITEM; review stated requirement | OFF | solder jumper (open, bridge with solder)
JP201 | MANUAL ITEM; review stated requirement | OFF | solder jumper (open, bridge with solder)
JP301 | MANUAL ITEM; review stated requirement | OFF | solder jumper (open, bridge with solder)
JP401 | MANUAL ITEM; review stated requirement | OFF | solder jumper (open, bridge with solder)
JP501 | MANUAL ITEM; review stated requirement | OFF | solder jumper (open, bridge with solder)
JP7003 | MANUAL ITEM; review stated requirement | PWM DFU BOOT (OPEN) | solder jumper (open, bridge with solder)
JP7005 | MANUAL ITEM; review stated requirement | PWM RESET (OPEN) | solder jumper (open, bridge with solder)
JP7101 | MANUAL ITEM; review stated requirement | OFF | solder jumper (open, bridge with solder)
TP1 | MANUAL ITEM; review stated requirement | VIN | bare copper test pad
TP101 | MANUAL ITEM; review stated requirement | 5V_PI | bare copper test pad
TP102 | MANUAL ITEM; review stated requirement | SW | bare copper test pad
TP2 | MANUAL ITEM; review stated requirement | GND | bare copper test pad
TP201 | MANUAL ITEM; review stated requirement | USB CONTROL 5V | bare copper test pad
TP202 | MANUAL ITEM; review stated requirement | SW | bare copper test pad
TP3 | MANUAL ITEM; review stated requirement | SW24 | bare copper test pad
TP301 | MANUAL ITEM; review stated requirement | 5V_SRV | bare copper test pad
TP302 | MANUAL ITEM; review stated requirement | SW | bare copper test pad
TP4 | MANUAL ITEM; review stated requirement | 24V | bare copper test pad
TP401 | MANUAL ITEM; review stated requirement | 12V_SRV | bare copper test pad
TP402 | MANUAL ITEM; review stated requirement | SW | bare copper test pad
TP5 | MANUAL ITEM; review stated requirement | PG24 | bare copper test pad
TP501 | MANUAL ITEM; review stated requirement | 12V_AUD | bare copper test pad
TP502 | MANUAL ITEM; review stated requirement | SW | bare copper test pad
TP7002 | MANUAL ITEM; review stated requirement | PWM3V3 | bare copper test pad
TP7003 | MANUAL ITEM; review stated requirement | PWM OE_N | bare copper test pad
TP7004 | MANUAL ITEM; review stated requirement | GND | bare copper test pad
TP7101 | MANUAL ITEM; review stated requirement | V5_SERVO | bare copper test pad
TP7102 | MANUAL ITEM; review stated requirement | SW | bare copper test pad
U9903 | MANUAL ITEM; review stated requirement | TLV3011BIDBVR MANUAL FIT | Texas Instruments TLV3011BIDBVR | C20345920 | MANDATORY MANUAL FIT; JLC stock0; B version VDD0 fail-safe input/POR high-Z; rawVBUS valid comparator
U9903 | MANDATORY HAND FIT before USB use | VBUS comparator, B suffix required | TI TLV3011BIDBVR | 296-TLV3011BIDBVRCT-ND | Not in fitted factory catalogue total; observed2026-11-09, not reserved/landed quote | 2.78 | USD | https://www.digikey.com/en/products/detail/texas-instruments/TLV3011BIDBVR/19236273
J3 Thor cable | MANDATORY for Thor connection | 300mm18AWG factory crimped four-circuit Micro-Fit cable | Molex2147551042 | 900-2147551042-ND | Official1↔2,3↔4 preserves power groups. Meter delivered cable before power.
Battery disconnect | MANDATORY | DC-rated mechanical DPST with four heavy wires | External switch, separately mounted |  | Stop before OFF; disconnect both pack positive leads before they join. Not a two-wire downstream switch.
Power harness | MANDATORY | Source-end pack fuses, branch fuses, sized conductors, supported connectors | Current inventory F1/F2/F7000 plus pack-source protection |  | Verify fuse interruption/overload coordination and complete harness continuity before battery operation.
Supports/firmware | MANDATORY before robot operation | Nylon supports, wire strain relief; flash the PWM STM32 controller | Current board supports and firmware/robot_io |  | Board must not carry heavy cable forces unsupported; firmware is not installed by BOM/CPL export.
