jloganolson/logans-first-robot-pcb/renders/assembly-top.png

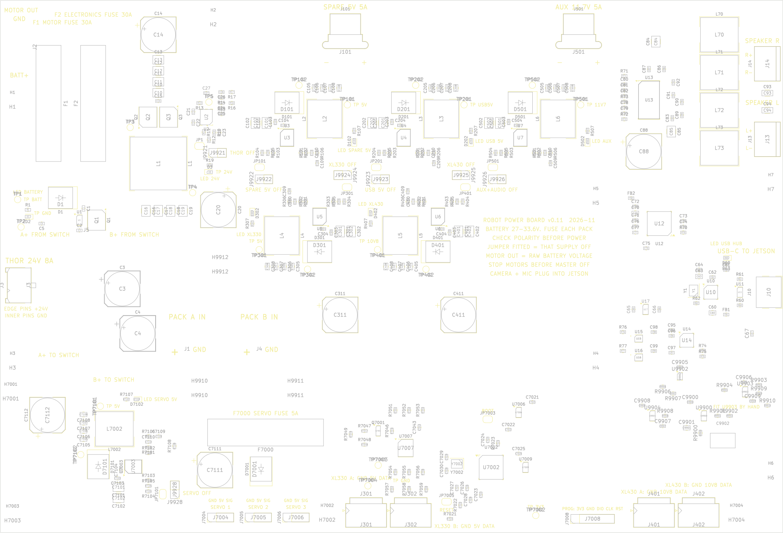
renders/assembly-top.png
