jloganolson/logans-first-robot-pcb/renders/schematic.pdf

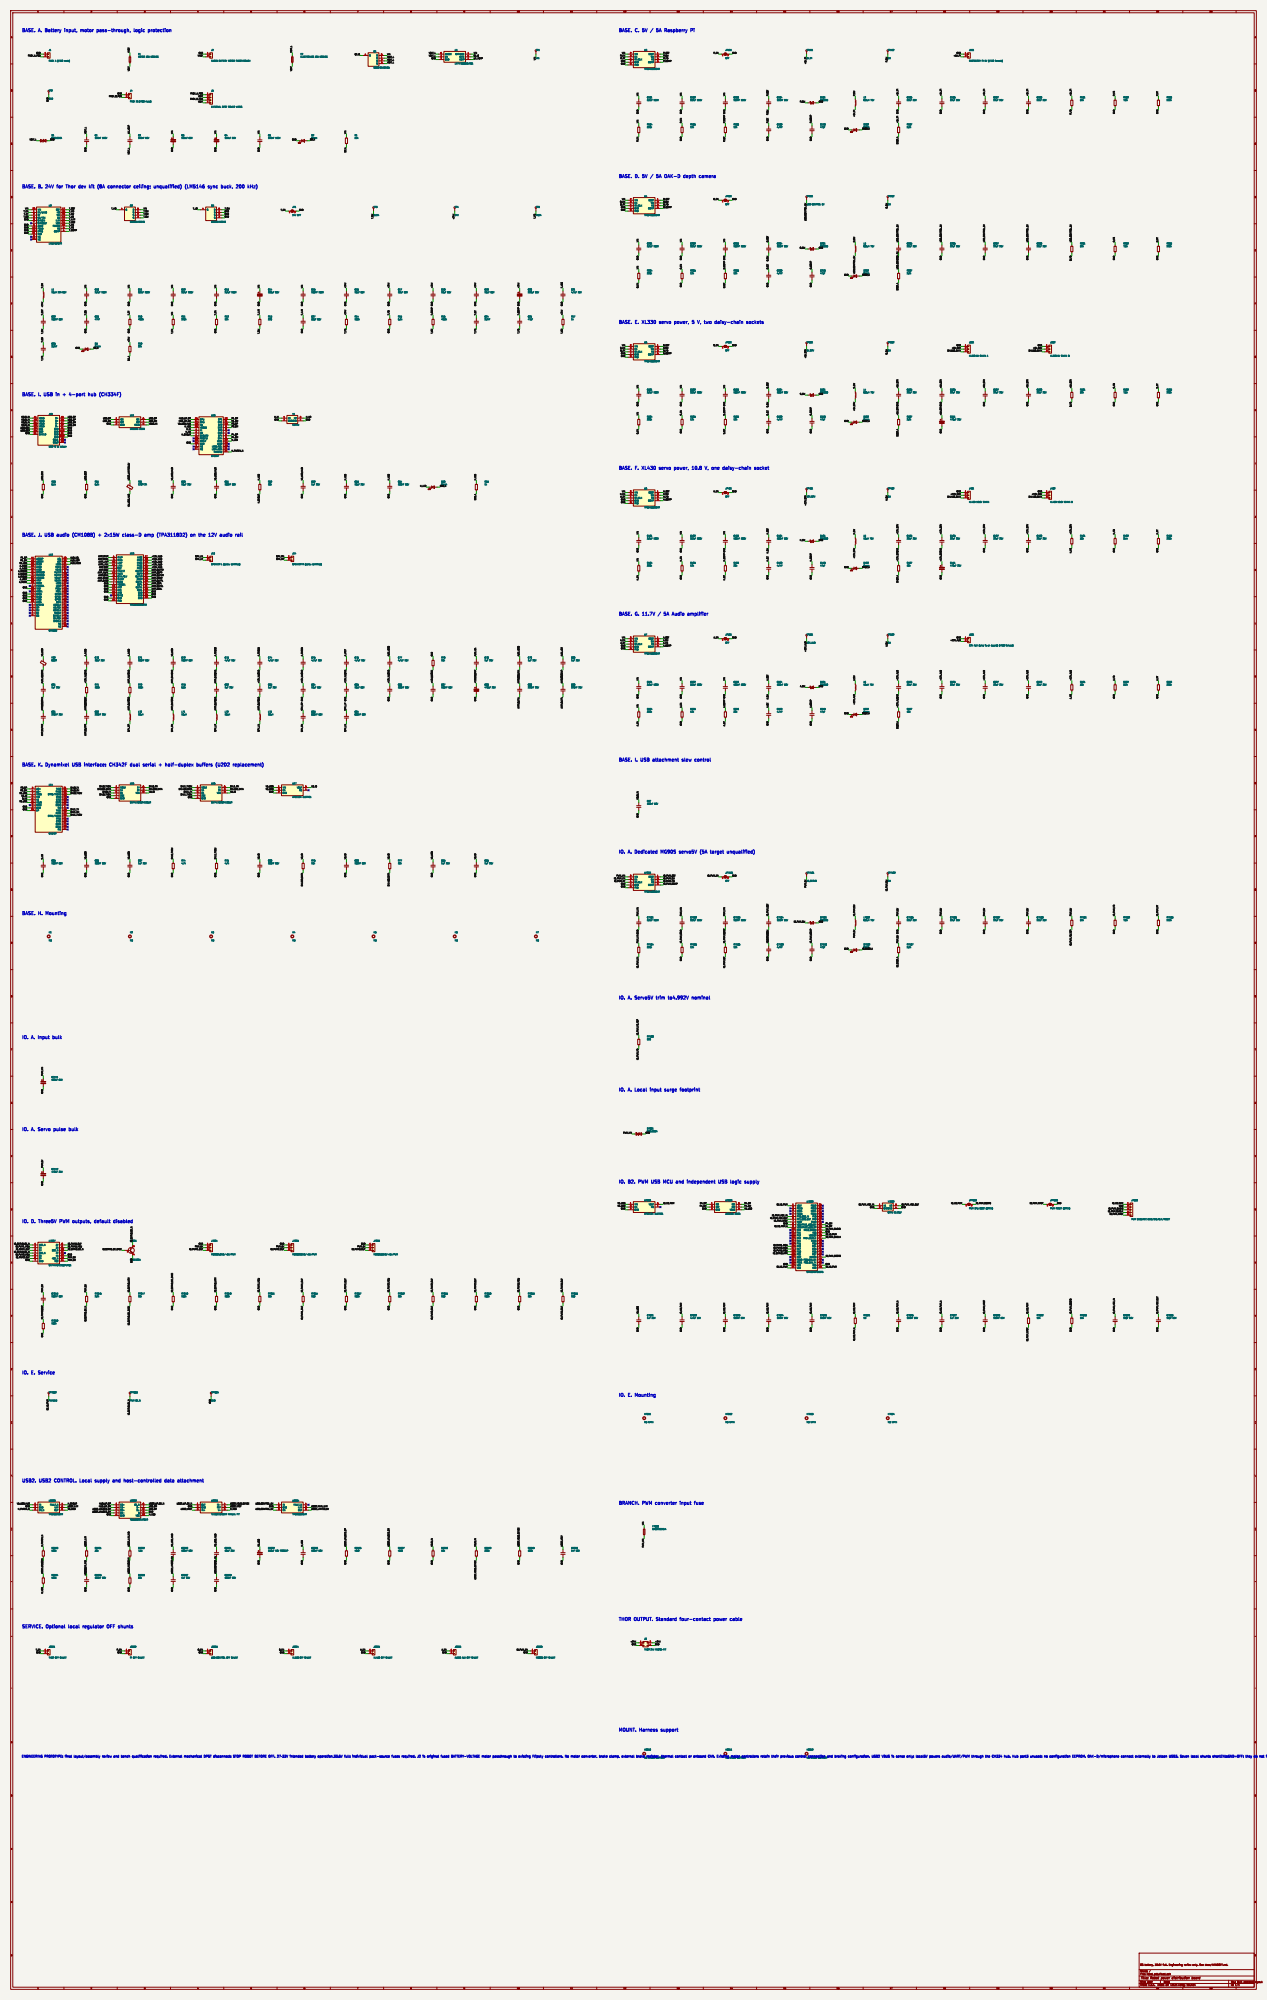
[picture p11: page 1]

BASE. D. 5V / 5A OAK-D depth camera

J13 SPEAKER L (screw terminal) MODSEL 1

AUD_LOL GND GND GND GND

12V AUX (amp is on board) (XT30 female)

IO. A. Dedicated MG90S servo5V (5A target unqualified)

IO. A. Local input surge footprint

IO. A. Servo pulse bulk

IO. B2. PWM USB MCU and independent USB logic supply

J7008 PWM SWD:VREF/GND/DIO/CLK/RESET VIN

BRANCH. PWM converter input fuse

SERVICE. Optional local regulator OFF shunts
