jloganolson/logans-first-robot-pcb/revisions/v0.11/kicad/robot_pdb.kicad_pcb

## KiCad design revisions/v0.11/kicad/robot_pdb.kicad_pcb (2026-11-11)

Schematic: robot_pdb.kicad_sch, Robot power distribution board

Parts:
C1, C5, C15, C103, C203, C303, C403, C503, C7103: 100nF 100V; C_0603_1608Metric; MPN MLCC X7R 100nF 100V; LCSC C15725
C2, C22, C61, C64, C71, C72, C86, C87, C95, C96, C98, C99, C104, C204, C304, C404, C504, C7023, C7024, C7025, C7026, C7028, C7043, C7104, C9900, C9905, C9906, C9908: 100nF 50V; C_0603_1608Metric; MPN MLCC X7R 100nF 50V; LCSC C14663
C3, C4, C14, C7111: 100uF 63V; CP_Elec_10x10; MPN Lelon VE-101M1JTR-1010 100uF 63V 10x10mm; LCSC C249468
C10, C11, C12, C13, C101, C102, C201, C202, C301, C302, C401, C402, C501, C502, C7101, C7102: 2.2uF 100V; C_1210_3225Metric; MPN MLCC X7R 2.2uF 100V; LCSC C55151
C16, C17, C18, C19, C84, C85: 10uF 50V; C_1210_3225Metric; MPN MLCC X7R 10uF 50V; LCSC C138687
C20: 220uF 35V; CP_Elec_10x10; MPN Lelon VUX221M1VTR-1010 220uF 35V 10x10mm; LCSC C3029711
C21, C73, C74, C75, C76, C77, C7022: 4.7uF 16V; C_0603_1608Metric; MPN MLCC X5R 4.7uF 16V; LCSC C19666
C23: 47nF; C_0603_1608Metric; MPN MLCC X7R 47nF; LCSC C1622
C24, C26: 2.2nF; C_0603_1608Metric; MPN MLCC X7R 2.2nF; LCSC C1604
C25, C110, C210, C310, C410, C510, C7110: 47pF; C_0603_1608Metric; MPN MLCC X7R 47pF; LCSC C1671
C27: 33pF 50V; C_0603_1608Metric; MPN MLCC C0G 33pF 50V; LCSC C1663
C60, C63, C70, C9901: 10uF 25V; C_0805_2012Metric; MPN MLCC X7R 10uF 25V; LCSC C15850
C62, C65, C66, C78, C79, C80, C81, C82, C83, C97, C7021, C7027, C9907: 1uF 25V; C_0603_1608Metric; MPN MLCC X7R 1uF 25V; LCSC C15849
C67: 100nF 50V; C_0603_1608Metric; MPN Yageo CC0603KRX7R9BB104; LCSC C14663
C88, C311, C411: 470uF 25V; CP_Elec_10x10; MPN Lelon VZH471M1ETR-1010 470uF 25V 10x10m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; LCSC C249933
C89, C90, C91, C92: 220nF 25V; C_0603_1608Metric; MPN MLCC X7R 220nF 25V; LCSC C21120
C93, C94: 680nF 50V; C_1206_3216Metric; MPN MLCC X7R 680nF 50V; LCSC C1881
C105, C106, C107, C108, C205, C206, C207, C208, C305, C306, C307, C308, C405, C406, C407, C408, C505, C506, C507, C508, C7105, C7106, C7107, C7108: 22uF 25V; C_0805_2012Metric; MPN MLCC X5R 22uF 25V; LCSC C45783
C109, C209, C309, C409, C509, C7109: 4.7nF; C_0603_1608Metric; MPN MLCC X7R 4.7nF; LCSC C53987
C7029, C7030: 18pF 50V; C_0603_1608Metric; MPN Samsung CL10C180JB8NNNC C0G5%; LCSC C1647
C7112: 470uF 25V; CP_Elec_10x10; MPN Lelon VZH471M1ETR-1010; LCSC C249933
C9902: 150uF 10V POSCAP; Panasonic_POSCAP_D3L; MPN Panasonic 10TPF150ML; LCSC C347559
C9909: 1nF 50V; C_0603_1608Metric; MPN Samsung CL10B102KB8NNNC; LCSC C1588
D1: SMCJ36CA; D_SMC; MPN Littelfuse SMCJ36CA bidirectional 36V T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; LCSC C151283
D2, D3, D60, D102, D202, D302, D402, D502, D7102: Green; LED_0603_1608Metric; MPN KT-0603G 0603 green LED; LCSC C12624
D101, D201, D301, D401, D501, D7101: SS1060; D_SMC; MPN SS1060 60V 10A SMC; LCSC C2922189
D7001: SMCJ36CA; D_SMC; MPN Littelfuse SMCJ36CA; LCSC C151283
F1: MOTOR 30A 500VDC; Fuse_505_Axial_P40mm; MPN Littelfuse 0505030.MXEP 30A 500VDC 20kA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; LCSC C187656
F2: ELECTRONICS 30A 500VDC; Fuse_505_Axial_P40mm; MPN Littelfuse 0505030.MXEP 30A 500VDC 20kA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; LCSC C187656
F7000: 5A63VDC20kA; Fuse_Schurter_SHF_6.3x32_P40mm; MPN SCHURTER8020.5075.PT
FB1: 120R 2A; L_0603_1608Metric; MPN Murata BLM18PG121SN1D; LCSC C14709
FB2: 600R; L_0603_1608Metric; MPN Sunlord GZ1608D601TF; LCSC C1002
H1, H2, H3, H4, H5, H6, H7: M3; MountingHole_3.2mm_M3
H7001, H7002, H7003, H7004: M3 NPTH; MountingHole_3.2mm_M3; MPN M3 NPTH
H9910, H9911, H9912: M3 NYLON SUPPORT; MountingHole_3.2mm_M3; MPN M3 nylon/insulating standoff
J1: PACK A (XT60 male); Power_WirePort_P7.2mm; MPN Hand-soldered 12AWG power pigtail; exte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
J2: FUSED BATTERY MOTOR PASSTHROUGH; Power_WirePort_P7.2mm; MPN Hand-soldered 12AWG power pigtail; exte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
J3: THOR 24V MICRO-FIT; MicroFit_43045_0412_4P_2oz; MPN Molex430450412; LCSC C277721
J4: PACK B (XT60 male); Power_WirePort_P7.2mm; MPN Hand-soldered 12AWG power pigtail; exte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
J5: EXTERNAL DPST POWER WIRES; Disconnect_WirePort_4Circuit; MPN Four hand-soldered 12AWG wires to exter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
J10: USB-C to Jetson; USB_C_HRO_31M12_2oz; MPN HRO TYPE-C-31-M-12 USB-C receptacle; LCSC C165948
J13: SPEAKER L (screw terminal); TerminalBlock_bornier-2_P5.08mm; MPN Kefa KF301-5.0-2P; LCSC C474881
J14: SPEAKER R (screw terminal); TerminalBlock_bornier-2_P5.08mm; MPN Kefa KF301-5.0-2P; LCSC C474881
J101: RASPBERRY PI 5V (XT30 female); AMASS_XT30PW_F_2oz; MPN Amass XT30PW-F; LCSC C2913282
J301: XL330 5V CHAIN A; JST_VH_B3P-VH_1x03_P3.96mm_Vertical; MPN JST B3P-VH(LF)(SN), use VHR-3N mating h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; LCSC C160316
J302: XL330 5V CHAIN B; JST_VH_B3P-VH_1x03_P3.96mm_Vertical; MPN JST B3P-VH(LF)(SN), use VHR-3N mating h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; LCSC C160316
J401: XL430 10.8V CHAIN; JST_VH_B3P-VH_1x03_P3.96mm_Vertical; MPN JST B3P-VH(LF)(SN), use VHR-3N mating h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; LCSC C160316
J402: XL430 10.8V CHAIN B; JST_VH_B3P-VH_1x03_P3.96mm_Vertical; MPN JST B3P-VH(LF)(SN), use VHR-3N mating h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; LCSC C160316
J501: 12V AUX (amp is on board) (XT30 female); AMASS_XT30PW_F_2oz; MPN Amass XT30PW-F; LCSC C2913282
J7004: MG90S1:GND/+5V/PWM; PinHeader_1x03_P2.54mm_Vertical; MPN hand-fit three-pin servo header; center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
J7005: MG90S2:GND/+5V/PWM; PinHeader_1x03_P2.54mm_Vertical; MPN hand-fit three-pin servo header; center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
J7006: MG90S3:GND/+5V/PWM; PinHeader_1x03_P2.54mm_Vertical; MPN hand-fit three-pin servo header; center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
J7008: PWM SWD:VREF/GND/DIO/CLK/RESET; PinHeader_1x05_P2.54mm_Vertical; MPN hand-fit SWD service header; pin1 is ta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
J9921: THOR OFF SHUNT; PinHeader_1x02_P2.54mm_Vertical; MPN Optional hand-fit 2.54mm two-pin header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
J9922: PI OFF SHUNT; PinHeader_1x02_P2.54mm_Vertical; MPN Optional hand-fit 2.54mm two-pin header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
J9923: USB CONTROL OFF SHUNT; PinHeader_1x02_P2.54mm_Vertical; MPN Optional hand-fit 2.54mm two-pin header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
J9924: XL330 OFF SHUNT; PinHeader_1x02_P2.54mm_Vertical; MPN Optional hand-fit 2.54mm two-pin header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
J9925: XL430 OFF SHUNT; PinHeader_1x02_P2.54mm_Vertical; MPN Optional hand-fit 2.54mm two-pin header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
J9926: AUDIO AUX OFF SHUNT; PinHeader_1x02_P2.54mm_Vertical; MPN Optional hand-fit 2.54mm two-pin header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
J9928: MG90S OFF SHUNT; PinHeader_1x02_P2.54mm_Vertical; MPN Optional hand-fit 2.54mm two-pin header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
JP1: 24V OFF; SolderJumper-2_P1.3mm_Open_RoundedPad1.0x1.5mm; MPN solder jumper (open, bridge with solder)
JP101, JP201, JP301, JP401, JP501, JP7101: OFF; SolderJumper-2_P1.3mm_Open_RoundedPad1.0x1.5mm; MPN solder jumper (open, bridge with solder)
JP7003: PWM DFU BOOT (OPEN); SolderJumper-2_P1.3mm_Open_RoundedPad1.0x1.5mm; MPN solder jumper (open, bridge with solder)
JP7005: PWM RESET (OPEN); SolderJumper-2_P1.3mm_Open_RoundedPad1.0x1.5mm; MPN solder jumper (open, bridge with solder)
L1: 10uH 22A 60V; L_Coilcraft_XAL1510-103; MPN Coilcraft XAL1510-103MED; LCSC C3911782
L2, L3, L4, L7002: 6.8uH 75V; L_Sunlord_MWSA1004S; MPN Vishay IHLP4040DZER6R8M01 (75V, Isat 13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; LCSC C845080
L5, L6: 10uH 75V; L_Sunlord_MWSA1004S; MPN Vishay IHLP4040DZER100M01 (75V, Isat 12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; LCSC C845065
L70, L71, L72, L73: 10uH; L_Sunlord_MWSA1004S; MPN Sunlord MWSA1004S-100MT (same part as t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; LCSC C408487
Q1: BSC040N10NS5; TDSON-8-1; MPN Infineon BSC040N10NS5ATMA1 100V 4mR at 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; LCSC C534334
Q2: BSC034N06NS; TDSON-8-1; MPN Infineon BSC034N06NS (high side); LCSC C534325
Q3: BSC034N06NS; TDSON-8-1; MPN Infineon BSC034N06NS (low side); LCSC C534325
Q7001: MMBT3904; SOT-23; MPN JSCJ MMBT3904(RANGE:100-300); LCSC C20526
R1, R19: 22k; R_0603_1608Metric; MPN 0603 1% 22k; LCSC C31850
R10, R16: 49.9k; R_0603_1608Metric; MPN 0603 1% 49.9k; LCSC C23184
R11, R103, R104, R203, R204, R303, R304, R403, R404, R503, R504, R7103, R7104: 220k; R_0603_1608Metric; MPN 0603 1% 220k; LCSC C22961
R12, R105, R106, R205, R206, R305, R306, R405, R505, R7105, R7106: 12k; R_0603_1608Metric; MPN 0603 1% 12k; LCSC C22790
R13: 220; R_0603_1608Metric; MPN 0603 1% 220; LCSC C22962
R14: 150k; R_0603_1608Metric; MPN 0603 1% 150k; LCSC C22807
R15, R60, R61: 5.1k; R_0603_1608Metric; MPN 0603 1% 5.1k; LCSC C23186
R17, R63: 1k; R_0603_1608Metric; MPN 0603 1% 1k; LCSC C21190
R62, R70, R76, R77, R407, R507, R7022, R7023, R7047, R7051, R7052, R7053: 10k; R_0603_1608Metric; MPN 0603 1% 10k; LCSC C25804
R71, R72, R7048, R7049, R7057, R7058, R7059, R9900, R9904: 100k; R_0603_1608Metric; MPN 0603 1% 100k; LCSC C25803
R73: 5.6k; R_0603_1608Metric; MPN 0603 1% 5.6k; LCSC C23189
R74, R75: 4.7k; R_0603_1608Metric; MPN 0603 1% 4.7k; LCSC C23162
R101, R201, R301, R7101: 39k; R_0603_1608Metric; MPN 0603 1% 39k; LCSC C23153
R102, R202, R302, R7102, R9902: 7.5k; R_0603_1608Metric; MPN 0603 1% 7.5k; LCSC C23234
R107, R207, R307, R502, R7046, R7107: 2.2k; R_0603_1608Metric; MPN 0603 1% 2.2k; LCSC C4190
R401, R501, R9901: 30k; R_0603_1608Metric; MPN 0603 1% 30k; LCSC C22984
R402: 2.4k; R_0603_1608Metric; MPN 0603 1% 2.4k; LCSC C22940
R406, R506, R9908: 20k; R_0603_1608Metric; MPN 0603 1% 20k; LCSC C4184
R7021: 10; R_0603_1608Metric; MPN UNI-ROYAL 0603WAF100JT5E; LCSC C22859
R7054, R7055, R7056: 100; R_0603_1608Metric; MPN UNI-ROYAL 0603WAF1000T5E; LCSC C22775
R7108: 300; R_0603_1608Metric; MPN 0603 1% 300; LCSC C23025
R9903: 10k; R_0603_1608Metric; MPN UNI-ROYAL 0603WAF1002T5E; LCSC C25804
R9906, R9907: 49.9; R_0603_1608Metric; MPN UNI-ROYAL 0603WAF499JT5E; LCSC C23185
R9909: 220k; R_0603_1608Metric; MPN UNI-ROYAL 0603WAF2203T5E; LCSC C22961
R9910: 100k; R_0603_1608Metric; MPN UNI-ROYAL 0603WAF1003T5E; LCSC C25803
TP1: VIN; TestPoint_Pad_D1.5mm; MPN bare copper test pad
TP2, TP7004: GND; TestPoint_Pad_D1.5mm; MPN bare copper test pad
TP3: SW24; TestPoint_Pad_D1.5mm; MPN bare copper test pad
TP4: 24V; TestPoint_Pad_D1.5mm; MPN bare copper test pad
TP5: PG24; TestPoint_Pad_D1.5mm; MPN bare copper test pad
TP101: 5V_PI; TestPoint_Pad_D1.5mm; MPN bare copper test pad
TP102, TP202, TP302, TP402, TP502, TP7102: SW; TestPoint_Pad_D1.5mm; MPN bare copper test pad
TP201: USB CONTROL 5V; TestPoint_Pad_D1.5mm; MPN bare copper test pad
TP301: 5V_SRV; TestPoint_Pad_D1.5mm; MPN bare copper test pad
TP401: 12V_SRV; TestPoint_Pad_D1.5mm; MPN bare copper test pad
TP501: 12V_AUD; TestPoint_Pad_D1.5mm; MPN bare copper test pad
TP7002: PWM3V3; TestPoint_Pad_D1.5mm; MPN bare copper test pad
TP7003: PWM OE_N; TestPoint_Pad_D1.5mm; MPN bare copper test pad
TP7101: V5_SERVO; TestPoint_Pad_D1.5mm; MPN bare copper test pad
U1: LM74700QDBVRQ1; SOT-23-6; MPN TI LM74700-Q1 ideal diode controller; LCSC C2941042
U2: LM5146RGYR; Texas_RGY_R-PVQFN-N20_EP2.05x3.05mm; MPN Texas Instruments LM5146RGYR; LCSC C3188679
U3, U4, U5, U6, U7, U7003: TPS54560DDAR; TI_SO-PowerPAD-8_ThermalVias; MPN TI TPS54560 60V 5A buck; LCSC C31966
U10: CH334F; QFN-24-1EP_4x4mm_P0.5mm_EP2.6x2.6mm; MPN WCH CH334F USB 2.0 4-port hub (MTT); LCSC C5187527
U11: USBLC6-2SC6; SOT-23-6; MPN ST USBLC6-2SC6 USB ESD; LCSC C7519
U12: CM108B; LQFP-48_7x7mm_P0.5mm; MPN C-Media CM108B USB audio codec (crystal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; LCSC C371347
U13: TPA3118D2DAPR; HTSSOP-32-1EP_6.1x11mm_P0.65mm_EP5.2x11mm_Mask4.11x4.36mm_T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; MPN TI TPA3118D2 2x30W class-D, pad down; LCSC C46497
U14: CH342F; QFN-24-1EP_4x4mm_P0.5mm_EP2.6x2.6mm; MPN WCH CH342F USB to dual UART (half-duple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; LCSC C2841530
U15, U16: SN74LVC2G241DCUR; VSSOP-8_2.3x2mm_P0.5mm; MPN TI SN74LVC2G241 (RX buffer /OE, TX buff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; LCSC C10430
U17: AP2112K-3.3TRG1; SOT-23-5; MPN Diodes AP2112K-3.3TRG1, dedicated 3.3V 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; LCSC C51118
U7002: STM32F072CBT6; LQFP-48_7x7mm_P0.5mm; MPN ST STM32F072CBT6 128KB flash; LCSC C81720
U7006: AP2112K-3.3TRG1; SOT-23-5; MPN Diodes AP2112K-3.3TRG1; LCSC C51118
U7007: SN74AHCT125QPWRQ1; TSSOP-14_4.4x5mm_P0.65mm; MPN Texas Instruments SN74AHCT125QPWRQ1; LCSC C507215
U7009: USBLC6-2SC6; SOT-23-6; MPN ST USBLC6-2SC6; LCSC C7519
U9900: TPS2552DBVR; SOT-23-6; MPN Texas Instruments TPS2552DBVR; LCSC C46506
U9902: TS3USB221ARSER; Texas_UQFN-10_1.5x2mm_P0.5mm; MPN Texas Instruments TS3USB221ARSER; LCSC C128396
U9903: TLV3011BIDBVR MANUAL FIT; SOT-23-6; MPN Texas Instruments TLV3011BIDBVR; LCSC C20345920
U9904: TPS2553DBVR; SOT-23-6; MPN Texas Instruments TPS2553DBVR; LCSC C55266
Y1: 12MHz; Crystal_SMD_3225-4Pin_3.2x2.5mm; MPN 12MHz 3225 crystal (CH334F has internal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; LCSC C9002
Y7002: 8MHz CL12pF; Crystal_SMD_3225-4Pin_3.2x2.5mm; MPN YXC X32258MOB4SI; LCSC C2682775

Connections:
+5V_PI: C105.1, C106.1, C107.1, C108.1, J101.2, L2.2, R101.1, R107.1, TP101.1
+5V_SRV: C305.1, C306.1, C307.1, C308.1, C311.1, J301.2, J302.2, L4.2, R301.1, R307.1, TP301.1
+12V_AUD: C83.1, C84.1, C85.1, C86.1, C87.1, C88.1, C505.1, C506.1, C507.1, C508.1, J501.2, L6.2, R71.1, R501.1, R507.1, TP501.1, U13.17 (AVCC), U13.18 (PVCC), U13.19 (PVCC), U13.31 (PVCC), U13.32 (PVCC)
+12V_SRV: C405.1, C406.1, C407.1, C408.1, C411.1, J401.2, J402.2, L5.2, R401.1, R407.1, TP401.1
+24V: C16.1, C17.1, C18.1, C19.1, C20.1, J3.1, J3.2, L1.2, R14.1, R17.1, R19.1, TP4.1
AMP_BSNL: C89.1, U13.20 (BSNL)
AMP_BSNR: C91.1, U13.26 (BSNR)
AMP_BSPL: C90.1, U13.24 (BSPL)
AMP_BSPR: C92.1, U13.30 (BSPR)
AMP_GAIN: R73.1, U13.8 (GAIN/SLV)
AMP_GVDD: C82.1, U13.6 (PLIMIT), U13.7 (GVDD)
AMP_LINN: C79.2, U13.11 (LINN)
AMP_LINP: C78.2, U13.10 (LINP)
AMP_MUTE: R72.1, U13.12 (MUTE)
AMP_OUTNL: C89.2, L73.1, U13.21 (OUTNL)
AMP_OUTNR: C91.2, L71.1, U13.27 (OUTNR)
AMP_OUTPL: C90.2, L72.1, U13.23 (OUTPL)
AMP_OUTPR: C92.2, L70.1, U13.29 (OUTPR)
AMP_RINN: C81.2, U13.5 (RINN)
AMP_RINP: C80.2, U13.4 (RINP)
AMP_SDZ: R71.2, U13.2 (SDZ), U13.3 (FAULTZ)
AUD_LOBS: C77.1, C79.1, C81.1, U12.31 (LOBS)
AUD_LOL: C78.1, U12.30 (LOL)
AUD_LOR: C80.1, U12.32 (LOR)
A_AVDD: C70.1, C71.1, FB2.2, U12.29 (AVDD), U12.34 (AVDD)
A_BST: C504.1, U7.1 (BOOT)
A_COMP: C510.1, R506.1, U7.6 (COMP)
A_CZ: C509.1, R506.2
A_EN: J9926.1, JP501.1 (A), R504.2, R505.1, U7.3 (EN)
A_FB: R501.2, R502.1, U7.5 (FB)
A_MODE: R70.2, U12.10 (MODE)
A_REG18: C73.1, U12.8 (DREG18)
A_REG33: C74.1, U12.9 (DREG33)
A_REG36: C75.1, U12.37 (AREG36)
A_RT: R503.1, U7.4 (RT/CLK)
A_SW: C504.2, D501.1 (K), L6.1, TP502.1, U7.8 (SW)
A_VREF: C76.1, U12.26 (VREF)
D2_A: D2.2 (A), R1.2
D3_A: D3.2 (A), R19.2
D60_A: D60.2 (A), R63.2
D102_A: D102.2 (A), R107.2
D202_A: D202.2 (A), R207.2
D302_A: D302.2 (A), R307.2
D402_A: D402.2 (A), R407.2
D502_A: D502.2 (A), R507.2
DXL0_RX: U14.20 (RXD0), U15.6 (1Y)
DXL0_TNOW: R74.1, U14.23 (DTR0/TNOW0), U15.1 (1OE#), U15.7 (2OE)
DXL0_TX: U14.21 (TXD0), U15.5 (2A)
DXL1_RX: U14.12 (RXD1), U16.6 (1Y)
DXL1_TNOW: R75.1, U14.15 (DTR1/TNOW1), U16.1 (1OE#), U16.7 (2OE)
DXL1_TX: U14.13 (TXD1), U16.5 (2A)
DXL330_DATA: J301.3, J302.3, R76.2, U15.2 (1A), U15.3 (2Y)
DXL430_DATA: J401.3, J402.3, R77.2, U16.2 (1A), U16.3 (2Y)
GND: C1.2, C3.2, C4.2, C5.2, C10.2, C11.2, C12.2, C13.2, C14.2, C15.2, C16.2, C17.2, C18.2, C19.2, C20.2, C21.2, C23.2, C27.2, C60.2, C61.2, C62.2, C63.2, C64.2, C65.2, C66.2, C67.2, C70.2, C71.2, C72.2, C73.2, C74.2, C75.2, C76.2, C77.2, C82.2, C83.2, C84.2, C85.2, C86.2, C87.2, C88.2, C95.2, C96.2, C97.2, C98.2, C99.2, C101.2, C102.2, C103.2, C105.2, C106.2, C107.2, C108.2, C109.2, C110.2, C201.2, C202.2, C203.2, C205.2, C206.2, C207.2, C208.2, C209.2, C210.2, C301.2, C302.2, C303.2, C305.2, C306.2, C307.2, C308.2, C309.2, C310.2, C311.2, C401.2, C402.2, C403.2, C405.2, C406.2, C407.2, C408.2, C409.2, C410.2, C411.2, C501.2, C502.2, C503.2, C505.2, C506.2, C507.2, C508.2, C509.2, C510.2, C7021.2, C7022.2, C7023.2, C7024.2, C7025.2, C7026.2, C7027.2, C7028.2, C7029.2, C7030.2, C7043.2, C7101.2, C7102.2, C7103.2, C7105.2, C7106.2, C7107.2, C7108.2, C7109.2, C7110.2, C7111.2, C7112.2, C9900.2, C9901.2, C9902.2, C9905.2, C9906.2, C9907.2, C9908.2, C9909.2, D1.2 (A2), D2.1 (K), D3.1 (K), D101.2 (A), D102.1 (K), D201.2 (A), D202.1 (K), D301.2 (A), D302.1 (K), D401.2 (A), D402.1 (K), D501.2 (A), D502.1 (K), D7001.2 (A2), D7101.2 (A), D7102.1 (K), J1.1, J2.1, J3.3, J3.4, J4.1, J10.A1 (GND), J10.A12 (GND), J10.B1 (GND), J10.B12 (GND), J10.S1 (SHIELD), J101.1, J301.1, J302.1, J401.1, J402.1, J501.1, J7004.1, J7005.1, J7006.1, J7008.2, J9921.2, J9922.2, J9923.2, J9924.2, J9925.2, J9926.2, J9928.2, JP1.2 (B), JP101.2 (B), JP201.2 (B), JP301.2 (B), JP401.2 (B), JP501.2 (B), JP7005.2 (B), JP7101.2 (B), Q3.1 (S), Q3.2 (S), Q3.3 (S), Q7001.2 (E), R10.2, R12.2, R15.2, R60.2, R61.2, R70.1, R72.2, R73.2, R74.2, R75.2, R102.2, R103.2, R105.2, R202.2, R203.2, R205.2, R302.2, R303.2, R305.2, R402.2, R403.2, R405.2, R502.2, R503.2, R505.2, R7023.2, R7048.2, R7049.2, R7051.2, R7052.2, R7053.2, R7057.2, R7058.2, R7059.2, R7102.2, R7103.2, R7105.2, R9902.2, R9903.2, R9906.2, R9907.2, R9908.2, R9910.2, TP2.1, TP7004.1, U1.2 (GND), U2.6 (AGND), U2.8 (SYNCIN), U2.12 (PGND), U2.15 (EP15), U2.21 (PAD), U3.7 (GND), U3.9 (PAD), U4.7 (GND), U4.9 (PAD), U5.7 (GND), U5.9 (PAD), U6.7 (GND), U6.9 (PAD), U7.7 (GND), U7.9 (PAD), U10.25 (GND), U11.2 (GND), U12.14 (DVSS), U12.23 (TEST), U12.24 (AVSS), U12.33 (AVSS), U12.36 (DVSS), U13.1 (MODSEL), U13.9 (GND), U13.13 (AM2), U13.14 (AM1), U13.15 (AM0), U13.22 (GND), U13.25 (GND), U13.28 (GND), U13.33 (PAD), U14.2 (GND), U14.25 (EP), U15.4 (GND), U16.4 (GND), U17.2 (GND), U7002.8 (VSSA), U7002.23 (VSS), U7002.35 (VSS), U7002.47 (VSS), U7003.7 (GND), U7003.9 (PAD), U7006.2 (GND), U7007.7 (GND), U7007.12 (4A), U7009.2 (GND), U9900.2 (GND), U9902.5 (GND), U9902.9 (S), U9903.2 (GND), U9904.2 (GND), Y1.2 (GND), Y1.4 (GND), Y7002.2 (GND), Y7002.4 (GND)
HUB_PSELF_NC: U10.18 (PSELF)
HUB_UP_DM: U10.14 (DMU), U9902.2 (1D-)
HUB_UP_DP: U10.15 (DPU), U9902.1 (1D+)
H_BST: C404.1, U6.1 (BOOT)
H_COMP: C410.1, R406.1, U6.6 (COMP)
H_CZ: C409.1, R406.2
H_EN: J9925.1, JP401.1 (A), R404.2, R405.1, U6.3 (EN)
H_FB: R401.2, R402.1, U6.5 (FB)
H_LED: D60.1 (K), U10.22 (LED1)
H_OVCUR: R62.2, U10.1 (OVCUR#), U9900.4 (FAULT_N)
H_PWREN_N: R9900.1, U10.24 (PWREN#), U9900.3 (EN_N)
H_RT: R403.1, U6.4 (RT/CLK)
H_SW: C404.2, D401.1 (K), L5.1, TP402.1, U6.8 (SW)
H_V33: C63.1, C64.1, C9905.1, C9906.1, R62.1, R63.1, R9900.2, R9904.2, U10.20 (VDD33), U9902.10 (VCC), U9903.6 (V+)
H_XI: U10.4 (XI), Y1.1 (X1)
H_XO: U10.3 (XO), Y1.3 (X2)
IO_D102_A: D7102.2 (A), R7107.2
IO_NC_PWM_2: U7002.2 (PC13)
IO_NC_PWM_3: U7002.3 (PC14)
IO_NC_PWM_4: U7002.4 (PC15)
IO_NC_PWM_10: U7002.10 (PA0)
IO_NC_PWM_11: U7002.11 (PA1)
IO_NC_PWM_12: U7002.12 (PA2)
IO_NC_PWM_13: U7002.13 (PA3)
IO_NC_PWM_14: U7002.14 (PA4)
IO_NC_PWM_15: U7002.15 (PA5)
IO_NC_PWM_20: U7002.20 (PB2)
IO_NC_PWM_21: U7002.21 (PB10)
IO_NC_PWM_22: U7002.22 (PB11)
IO_NC_PWM_25: U7002.25 (PB12)
IO_NC_PWM_26: U7002.26 (PB13)
IO_NC_PWM_27: U7002.27 (PB14)
IO_NC_PWM_28: U7002.28 (PB15)
IO_NC_PWM_29: U7002.29 (PA8)
IO_NC_PWM_30: U7002.30 (PA9)
IO_NC_PWM_31: U7002.31 (PA10)
IO_NC_PWM_38: U7002.38 (PA15)
IO_NC_PWM_39: U7002.39 (PB3)
IO_NC_PWM_40: U7002.40 (PB4)
IO_NC_PWM_41: U7002.41 (PB5)
IO_NC_PWM_42: U7002.42 (PB6)
IO_NC_PWM_43: U7002.43 (PB7)
IO_NC_PWM_45: U7002.45 (PB8_CAN_RX)
IO_NC_PWM_46: U7002.46 (PB9_CAN_TX)
IO_NC_PWM_BUFFER4: U7007.11 (4Y)
IO_PWM1_BUF: R7054.1, U7007.3 (1Y)
IO_PWM1_MCU: R7051.1, U7002.16 (PA6), U7007.2 (1A)
IO_PWM1_OUT: J7004.3, R7054.2, R7057.1
IO_PWM2_BUF: R7055.1, U7007.6 (2Y)
IO_PWM2_MCU: R7052.1, U7002.17 (PA7), U7007.5 (2A)
IO_PWM2_OUT: J7005.3, R7055.2, R7058.1
IO_PWM3_BUF: R7056.1, U7007.8 (3Y)
IO_PWM3_MCU: R7053.1, U7002.18 (PB0), U7007.9 (3A)
IO_PWM3_OUT: J7006.3, R7056.2, R7059.1
IO_PWM_BOOT0: JP7003.2 (B), R7023.1, U7002.44 (BOOT0)
IO_PWM_BST: C7104.1, U7003.1 (BOOT)
IO_PWM_COMP: C7110.1, R7106.1, U7003.6 (COMP)
IO_PWM_CZ: C7109.1, R7106.2
IO_PWM_EN: J9928.1, JP7101.1 (A), R7104.2, R7105.1, U7003.3 (EN)
IO_PWM_FB: R7102.1, R7108.2, U7003.5 (FB)
IO_PWM_FB_TOP: R7101.2, R7108.1
IO_PWM_HSE_IN: C7029.1, U7002.5 (PF0_OSC_IN), Y7002.1 (X1)
IO_PWM_HSE_OUT: C7030.1, U7002.6 (PF1_OSC_OUT), Y7002.3 (X2)
IO_PWM_NRST: C7028.1, J7008.5, JP7005.1 (A), R7022.2, U7002.7 (NRST)
IO_PWM_RT: R7103.1, U7003.4 (RT/CLK)
IO_PWM_SW: C7104.2, D7101.1 (K), L7002.1, TP7102.1, U7003.8 (SW)
IO_PWM_SWCLK: J7008.4, U7002.37 (PA14_SWCLK)
IO_PWM_SWDIO: J7008.3, U7002.34 (PA13_SWDIO)
IO_SERVO_ARM: R7047.1, R7049.1, U7002.19 (PB1)
IO_SERVO_OE_BASE: Q7001.1 (B), R7047.2, R7048.1
IO_SERVO_OE_N: Q7001.3 (C), R7046.2, TP7003.1, U7007.1 (1OE_N), U7007.4 (2OE_N), U7007.10 (3OE_N)
IO_V3_PWM: C7022.1, C7023.1, C7024.1, C7025.1, J7008.1, JP7003.1 (A), R7021.1, R7022.1, TP7002.1, U7002.1 (VBAT), U7002.24 (VDD), U7002.36 (VDDIO2), U7002.48 (VDD), U7006.5 (VOUT)
IO_V3_PWM_A: C7026.1, C7027.1, R7021.2, U7002.9 (VDDA)
NC_HUB_P3_DM: U10.7 (DM3)
NC_HUB_P3_DP: U10.8 (DP3)
O_BST: C204.1, U4.1 (BOOT)
O_COMP: C210.1, R206.1, U4.6 (COMP)
O_CZ: C209.1, R206.2
O_EN: J9923.1, JP201.1 (A), R204.2, R205.1, U4.3 (EN)
O_FB: R201.2, R202.1, U4.5 (FB)
O_RT: R203.1, U4.4 (RT/CLK)
O_SW: C204.2, D201.1 (K), L3.1, TP202.1, U4.8 (SW)
P1_DM: U10.11 (DM1), U12.42 (USBDM)
P1_DP: U10.12 (DP1), U12.41 (USBDP)
P2_DM: U10.9 (DM2), U14.4 (UD-)
P2_DP: U10.10 (DP2), U14.3 (UD+)
P4_DM: U10.5 (DM4), U7002.32 (PA11_USB_DM), U7009.3 (IO2), U7009.4 (IO2)
P4_DP: U10.6 (DP4), U7002.33 (PA12_USB_DP), U7009.1 (IO1), U7009.6 (IO1)
PACK_A_POS: J1.2, J5.1
PACK_B_POS: J4.2, J5.3
PWM_5V: C7043.1, C7105.1, C7106.1, C7107.1, C7108.1, C7112.1, J7004.2, J7005.2, J7006.2, L7002.2, R7046.1, R7101.1, R7107.1, TP7101.1, U7007.13 (4OE_N), U7007.14 (VCC)
PWM_VIN: C7101.1, C7102.1, C7103.1, C7111.1, D7001.1 (A1), F7000.2, R7104.1, U7003.2 (VIN)
P_BST: C104.1, U3.1 (BOOT)
P_COMP: C110.1, R106.1, U3.6 (COMP)
P_CZ: C109.1, R106.2
P_EN: J9922.1, JP101.1 (A), R104.2, R105.1, U3.3 (EN)
P_FB: R101.2, R102.1, U3.5 (FB)
P_RT: R103.1, U3.4 (RT/CLK)
P_SW: C104.2, D101.1 (K), L2.1, TP102.1, U3.8 (SW)
Q1_G: Q1.4 (G), U1.5 (GATE)
SPK_LN: C94.2, J13.1, L73.2
SPK_LP: C94.1, J13.2, L72.2
SPK_RN: C93.2, J14.1, L71.2
SPK_RP: C93.1, J14.2, L70.2
S_BST: C304.1, U5.1 (BOOT)
S_COMP: C310.1, R306.1, U5.6 (COMP)
S_CZ: C309.1, R306.2
S_EN: J9924.1, JP301.1 (A), R304.2, R305.1, U5.3 (EN)
S_FB: R301.2, R302.1, U5.5 (FB)
S_RT: R303.1, U5.4 (RT/CLK)
S_SW: C304.2, D301.1 (K), L4.1, TP302.1, U5.8 (SW)
S_V3: C95.1, U14.6 (V3)
T_BST: C22.1, U2.17 (BST)
T_C3: C26.1, R17.2
T_COMP: C25.1, R16.1, U2.4 (COMP)
T_CZ: C24.1, R16.2
T_EN: J9921.1, JP1.1 (A), R11.2, R12.1, U2.1 (EN/UVLO)
T_FB: C24.2, C25.2, C26.2, R14.2, R15.1, U2.5 (FB)
T_HO: Q2.4 (G), U2.18 (HO)
T_ILIM: C27.1, R13.1, U2.11 (ILIM)
T_LO: Q3.4 (G), U2.13 (LO)
T_NC9: U2.9 (NC)
T_NC16: U2.16 (NC)
T_PG: TP5.1, U2.10 (PGOOD)
T_RT: R10.1, U2.2 (RT)
T_SS: C23.1, U2.3 (SS/TRK)
T_SW: C22.2, L1.1, Q2.1 (S), Q2.2 (S), Q2.3 (S), Q3.5 (D), R13.2, TP3.1, U2.19 (SW)
T_SYNCOUT: U2.7 (SYNCOUT)
T_VCC: C21.1, U2.14 (VCC)
U1_VCAP: C2.1, U1.1 (VCAP)
USB2_ILIM: R9901.1, U9900.5 (ILIM)
USB2_ILIM_MID: R9901.2, R9902.1
USB2_LIMITED_5V: C9907.1, FB1.1, U9904.6 (OUT)
USB2_MAIN_FAULT_NC: U9904.4 (FAULT_N)
USB2_MAIN_ILIM: R9908.1, U9904.5 (ILIM)
USB2_UNUSED_DM: R9907.1, U9902.4 (2D-)
USB2_UNUSED_DP: R9906.1, U9902.3 (2D+)
USB2_UP_OE_N: R9904.1, U9902.6 (OE_N), U9903.1 (OUT)
USB2_VBUS_SENSE: R9909.2, R9910.1, U9903.4 (IN-)
USB2_VREF: C9909.1, U9903.3 (IN+), U9903.5 (REF)
USB_CC1: J10.A5 (CC1), R60.1
USB_CC2: J10.B5 (CC2), R61.1
USB_CONTROL_5V: C205.1, C206.1, C207.1, C208.1, C9908.1, L3.2, R201.1, R207.1, TP201.1, U9904.1 (IN), U9904.3 (EN)
USB_DM: J10.A7 (D-), J10.B7 (D-), U11.3 (IO2), U11.4 (IO2), U9902.7 (D-)
USB_DP: J10.A6 (D+), J10.B6 (D+), U11.1 (IO1), U11.6 (IO1), U9902.8 (D+)
V3_IO: C66.1, C98.1, C99.1, R76.1, R77.1, U14.5 (VIO), U15.8 (VCC), U16.8 (VCC), U17.5 (VOUT)
V5_USB: C65.1, C72.1, C96.1, C97.1, C7021.1, C9902.1, FB2.1, U12.35 (DVDD), U14.7 (VDD5), U14.8 (VBUS), U17.1 (VIN), U17.3 (EN), U7006.1 (VIN), U7006.3 (EN), U7009.5 (VBUS), U9900.6 (OUT)
V5_USB_HUB: C60.1, C61.1, C62.1, C9900.1, C9901.1, FB1.2, U10.19 (V5), U9900.1 (IN)
VBAT: F1.2, F2.2, J5.2, J5.4
VBAT_L: C1.1, C2.2, D1.1 (A1), F2.1, Q1.1 (S), Q1.2 (S), Q1.3 (S), U1.3 (EN), U1.6 (ANODE)
VBUS_IN: C67.1, J10.A4 (VBUS), J10.A9 (VBUS), J10.B4 (VBUS), J10.B9 (VBUS), R9903.1, R9909.1, U11.5 (VBUS)
VIN: C3.1, C4.1, C5.1, C10.1, C11.1, C12.1, C13.1, C14.1, C15.1, C101.1, C102.1, C103.1, C201.1, C202.1, C203.1, C301.1, C302.1, C303.1, C401.1, C402.1, C403.1, C501.1, C502.1, C503.1, F7000.1, Q1.5 (D), Q2.5 (D), R1.1, R11.1, R104.1, R204.1, R304.1, R404.1, R504.1, TP1.1, U1.4 (CATHODE), U2.20 (VIN), U3.2 (VIN), U4.2 (VIN), U5.2 (VIN), U6.2 (VIN), U7.2 (VIN)
VMOT: F1.1, J2.2

Notes on the sheet:
BASE. A. Battery input, motor pass-through, logic protection
BASE. B. 24V for Thor dev kit (8A connector ceiling; unqualified) (LM5146 sync buck, 200 kHz)
BASE. C. 5V / 5A Raspberry Pi
BASE. D. 5V / 5A OAK-D depth camera
BASE. E. XL330 servo power, 5 V, two daisy-chain sockets
BASE. F. XL430 servo power, 10.8 V, one daisy-chain socket
BASE. G. 11.7V / 5A Audio amplifier
BASE. I. USB in + 4-port hub (CH334F)
BASE. J. USB audio (CM108B) + 2x15W class-D amp (TPA3118D2) on the 12V audio rail
BASE. K. Dynamixel USB interface: CH342F dual serial + half-duplex buffers (U2D2 replacement)
BASE. H. Mounting
BASE. I. USB attachment slew control
IO. A. Dedicated MG90S servo5V (5A target unqualified)
IO. A. Servo5V trim to4.992V nominal
IO. A. Input bulk
IO. A. Local input surge footprint
IO. A. Servo pulse bulk
IO. B2. PWM USB MCU and independent USB logic supply
IO. D. Three5V PWM outputs, default disabled
IO. E. Service
IO. E. Mounting
USB2. USB2 CONTROL. Local supply and host-controlled data attachment
BRANCH. PWM converter input fuse
THOR OUTPUT. Standard four-contact power cable
SERVICE. Optional local regulator OFF shunts
MOUNT. Harness support
ENGINEERING PROTOTYPE; final layout/assembly review and bench qualification required. External mechanical DPST disconnect: STOP ROBOT BEFORE OFF. 27–33V intended battery operation,33.6V full; individual pack-source fuses required. J2 is original fused BATTERY-VOLTAGE motor passthrough to existing F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

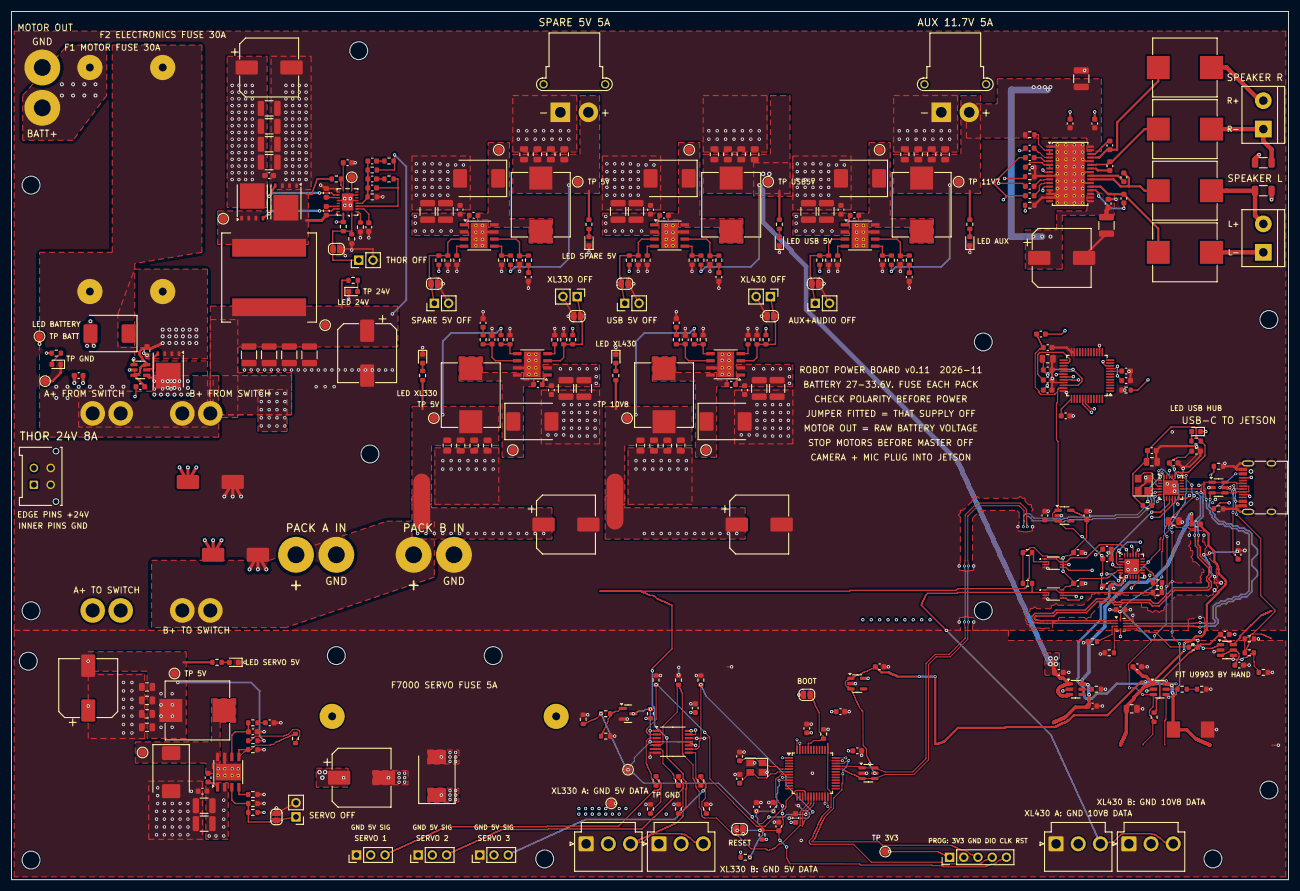
[picture p12: board robot_pdb.kicad_pcb from above]

Board: 4 copper layers, 228.0 x 155.0 mm, 366 parts (0 on the bottom side), 172 nets.
