jloganolson/logans-first-robot-pcb/(commit log)

2026-11-10 Robot power distribution board v0.10: design files, review material and JLCPCB order recipe
    Unbuilt prototype published for design review. See README.md for status and
    the open questions.
    [BOM_JLCPCB.csv, hand-fit-and-harness.csv, raw-positions.csv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]
2026-11-10 v0.11: compact 228 x 155 mm layout, Coilcraft inductor back on the Thor rail
    Re-floorplans the hobby-servo block that left a quarter of v0.10 empty.
    Everything outside that block is copper-identical to v0.10. Adds the
    generator, audit and export scripts, the JLCPCB package and dated quote
    ($305.40), an updated walkthrough and a review handoff.
    [BOM_JLCPCB.csv, hand-fit-and-harness.csv, raw-positions.csv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]
2026-11-10 v0.11 final: plugs on board edges, full silkscreen labels, corrected part rotations
    Moves the Thor and Dynamixel plugs to the board edges on new copper, replaces
    the silkscreen with 76 placed labels, applies fixes from an AI review of the
    first v0.11 build, and corrects thirteen part rotations in the JLCPCB
    placement file that had been wrong since v0.9. Quote $307.92; not ordered.
    [BOM_JLCPCB.csv, hand-fit-and-harness.csv, raw-positions.csv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]
2026-11-10 v0.11: 75 V inductors on the six TPS54560 rails, heat model re-run on the final board
    Sunlord MWSA1004S (30 V) at L2-L6 and L7002 become Vishay IHLP-4040DZ-01
    (75 V) on the existing pads. Thermal model re-run on v0.11 with a worst-case
    all-outputs-at-rating case. Quote $321.20; not ordered.
    [BOM_JLCPCB.csv, hand-fit-and-harness.csv, raw-positions.csv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]
2026-11-11 v0.11: fix XL330 5 V copper neck found by fabrication review; add pour-width check
    [BOM_JLCPCB.csv, hand-fit-and-harness.csv, raw-positions.csv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]
